OfficialPouya/Safety_Suite_For_Electric_Longboard/HalfWay_Report_Pouya/Diagrams:Photos/remote_pic1.jpg

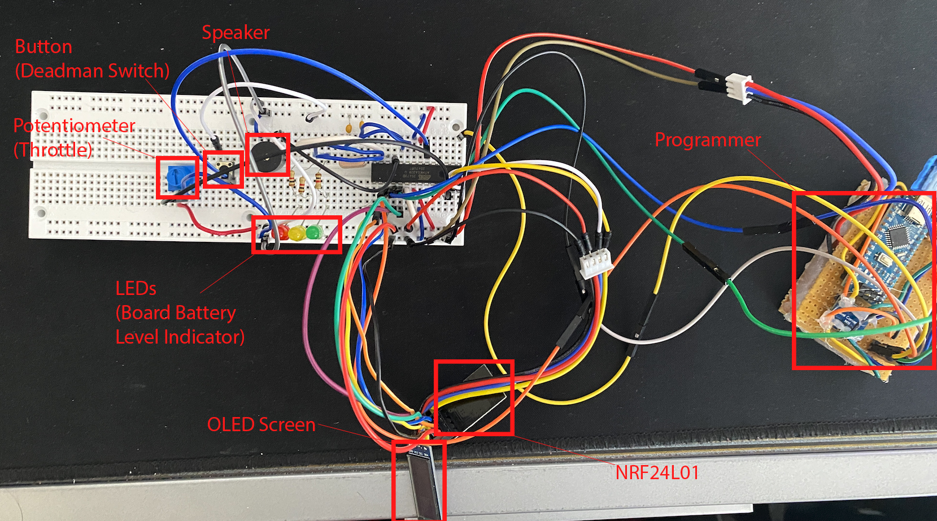
HalfWay_Report_Pouya/Diagrams:Photos/remote_pic1.jpg
