OfficialPouya/Safety_Suite_For_Electric_Longboard/3D_models/credit/Electric_longboard_remote_Heltec/images/7eb339b5feadf0e1b4344ece270d1d88_preview_featured.jpg

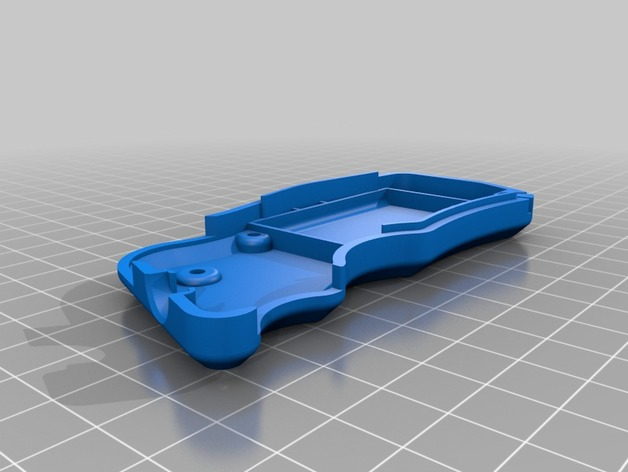
3D_models/credit/Electric_longboard_remote_Heltec/images/7eb339b5feadf0e1b4344ece270d1d88_preview_featured.jpg
