OfficialPouya/Safety_Suite_For_Electric_Longboard/README.md

# Safety Suite For Electric Longboard
This is my Senior Design (ECE 445) Project

The goal of the project is to increase Safety for electric longboard users. To find out more about the project, feel free to watch the presentation, demos, and the rest of this repository. This project would not have been possible without the help of Alex and Patrick. 

Best Overall Project Winner (Spring 2021)
-----
Best project out of 72 teams/projects

$1500 Award

Contributors
-----
[Pouya Akbarzadeh](https://github.com/OfficialPouya)

[Alexander Krysl](https://github.com/axkrysl47)

[Patrick Stach](https://github.com/pat-stach) 

Demo
-----
[Demo Videos](https://www.youtube.com/playlist?list=PLA1k06jt2lX-8_wawuwcJB9zIEW_f2nJa)

Presentation
-----
[Brief Presentaion](https://www.youtube.com/watch?v=MWs525hmZTg)

Final Results
-----
Board&Remote

OurTeam
