OfficialPouya/Safety_Suite_For_Electric_Longboard/3D_models/credit/Electric_longboard_remote_Heltec/images/69ffc595bfeba797f40aa1622941c01d_preview_featured.jpg

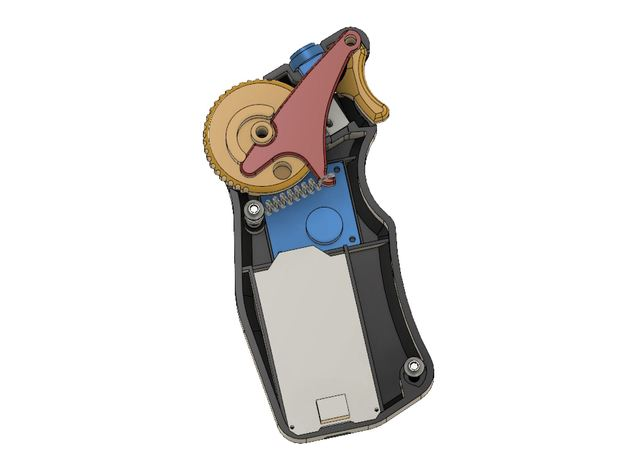
3D_models/credit/Electric_longboard_remote_Heltec/images/69ffc595bfeba797f40aa1622941c01d_preview_featured.jpg
