OfficialPouya/Safety_Suite_For_Electric_Longboard/3D_models/credit/Electric_longboard_remote_Heltec/images/98cde720821371f5c4195cfbfbd5da35_preview_featured.jpg

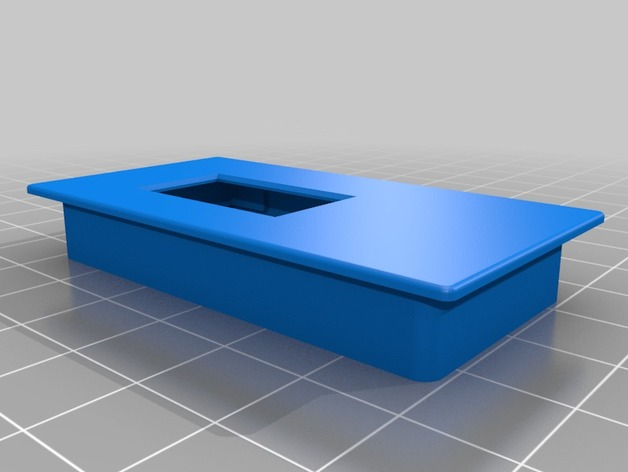
3D_models/credit/Electric_longboard_remote_Heltec/images/98cde720821371f5c4195cfbfbd5da35_preview_featured.jpg
