OfficialPouya/Safety_Suite_For_Electric_Longboard/3D_models/credit/Electric_longboard_remote_Heltec/images/386260dc76842ec5c13804833cbced2b_preview_featured.jpg

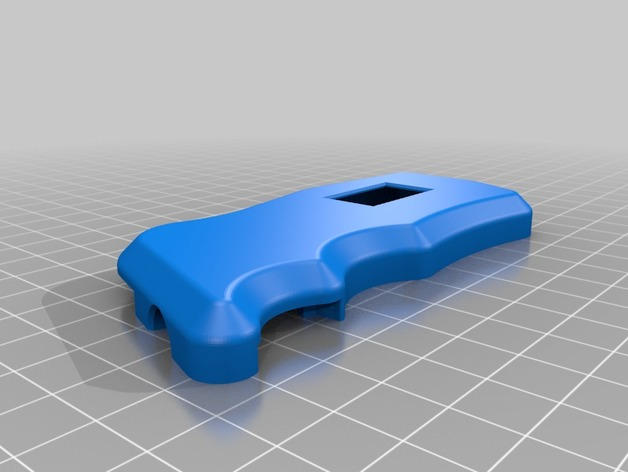
3D_models/credit/Electric_longboard_remote_Heltec/images/386260dc76842ec5c13804833cbced2b_preview_featured.jpg
