OfficialPouya/Safety_Suite_For_Electric_Longboard/3D_models/credit/Electric_longboard_remote_Heltec/images/a3805b81f7a539d40a509555a6355bbc_preview_featured.jpg

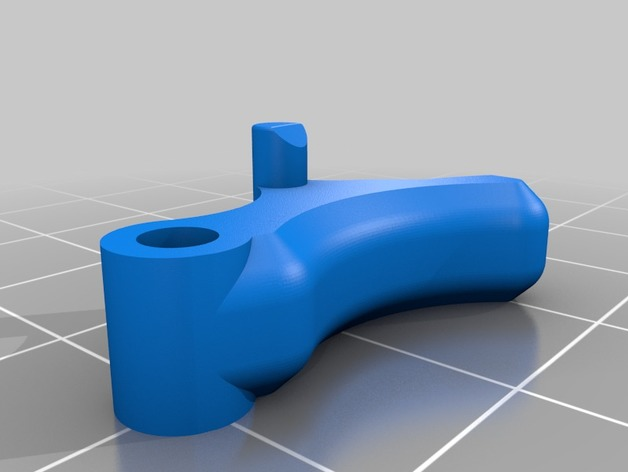
3D_models/credit/Electric_longboard_remote_Heltec/images/a3805b81f7a539d40a509555a6355bbc_preview_featured.jpg
