OfficialPouya/Safety_Suite_For_Electric_Longboard/3D_models/credit/Electric_longboard_remote_Heltec/images/b4461c6639c2007ad3c57c3150edbff9_preview_featured.jpg

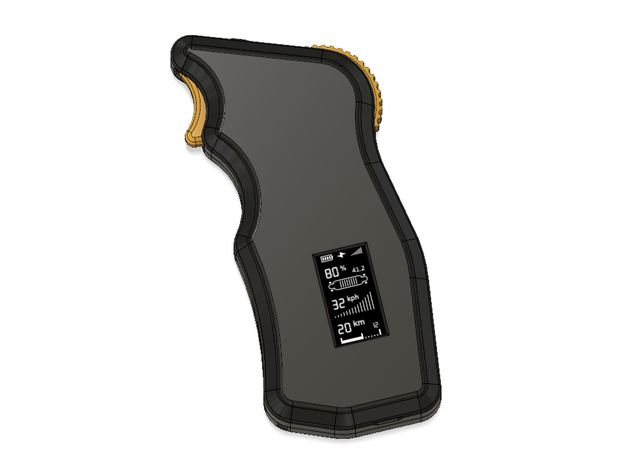
3D_models/credit/Electric_longboard_remote_Heltec/images/b4461c6639c2007ad3c57c3150edbff9_preview_featured.jpg
