OfficialPouya/Safety_Suite_For_Electric_Longboard/3D_models/credit/Electric_longboard_remote_Heltec/images/c8626185c7c38b2d3d5e2b3c0fde5403_preview_featured.jpg

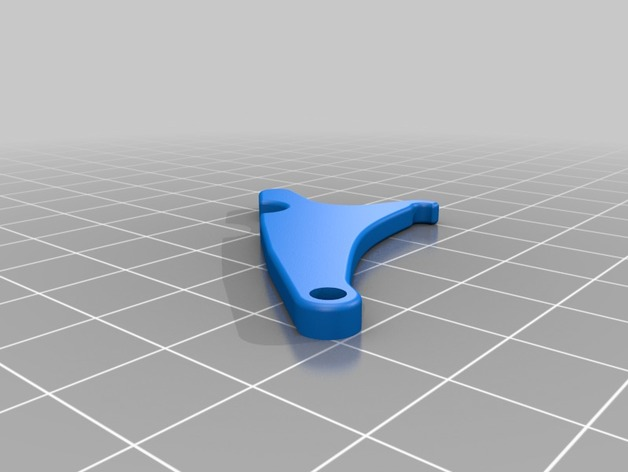
3D_models/credit/Electric_longboard_remote_Heltec/images/c8626185c7c38b2d3d5e2b3c0fde5403_preview_featured.jpg
