OfficialPouya/Safety_Suite_For_Electric_Longboard/3D_models/credit/Electric_longboard_remote_Heltec/images/d338848037ee6d17b909117afdbd7d65_preview_featured.jpg

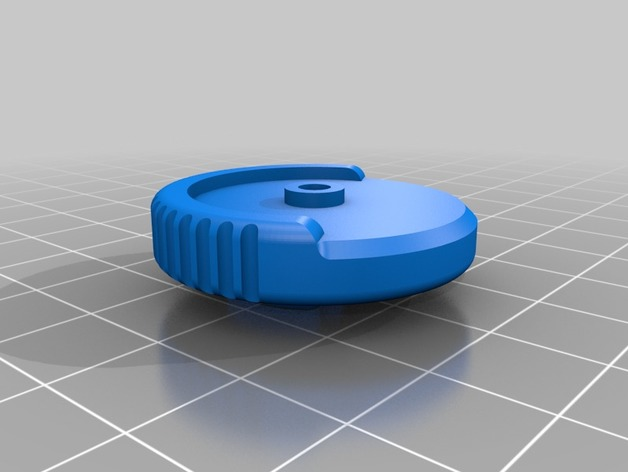
3D_models/credit/Electric_longboard_remote_Heltec/images/d338848037ee6d17b909117afdbd7d65_preview_featured.jpg
