OfficialPouya/Safety_Suite_For_Electric_Longboard/3D_models/credit/Electric_skateboard_motor_mount_-_Caliber_trucks/images/00dabf7ee72d4b01d702d320ba3350b1_preview_featured.jpg

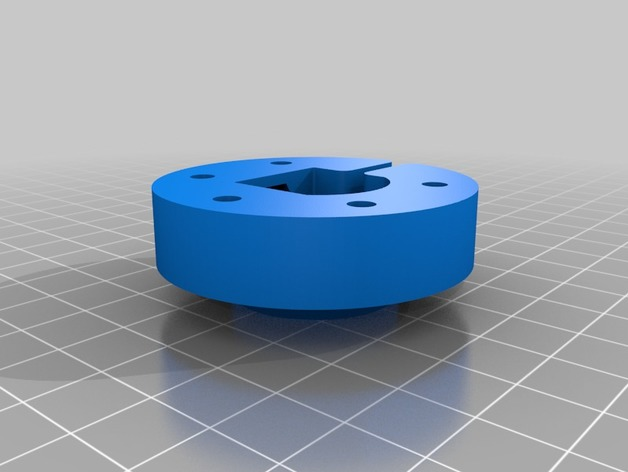
3D_models/credit/Electric_skateboard_motor_mount_-_Caliber_trucks/images/00dabf7ee72d4b01d702d320ba3350b1_preview_featured.jpg
