OfficialPouya/Safety_Suite_For_Electric_Longboard/3D_models/credit/Electric_skateboard_motor_mount_-_Caliber_trucks/images/650e578287d03ef3ec6c3ad758da1a24_preview_featured.jpg

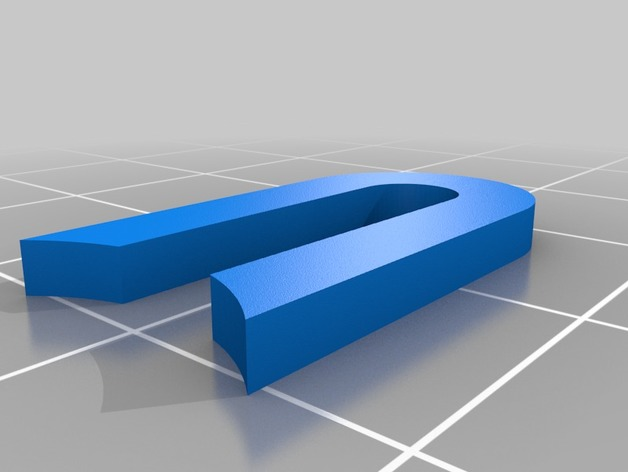
3D_models/credit/Electric_skateboard_motor_mount_-_Caliber_trucks/images/650e578287d03ef3ec6c3ad758da1a24_preview_featured.jpg
