OfficialPouya/Safety_Suite_For_Electric_Longboard/3D_models/credit/Electric_skateboard_motor_mount_-_Caliber_trucks/images/5272ebec7dc5c7aaa61b17ca818b53dd_preview_featured.jpg

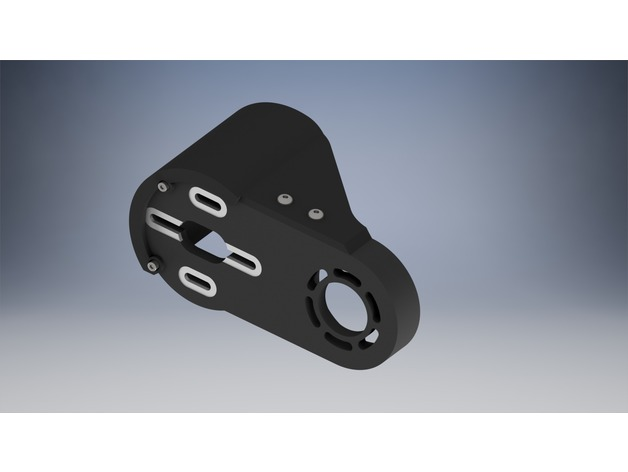
3D_models/credit/Electric_skateboard_motor_mount_-_Caliber_trucks/images/5272ebec7dc5c7aaa61b17ca818b53dd_preview_featured.jpg
