OfficialPouya/Safety_Suite_For_Electric_Longboard/3D_models/credit/Electric_skateboard_motor_mount_-_Caliber_trucks/images/8984e34767c9608245a1ef0f045a4798_preview_featured.jpg

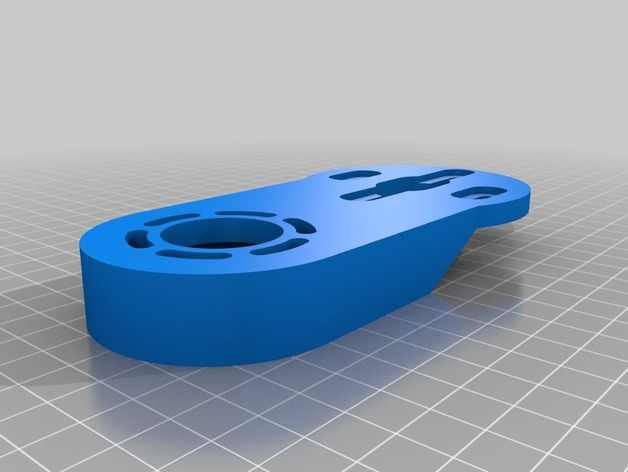
3D_models/credit/Electric_skateboard_motor_mount_-_Caliber_trucks/images/8984e34767c9608245a1ef0f045a4798_preview_featured.jpg
