OfficialPouya/Safety_Suite_For_Electric_Longboard/3D_models/credit/Electric_skateboard_motor_mount_-_Caliber_trucks/images/a8a3e114f2ad8216c0342388b4845f85_preview_featured.jpg

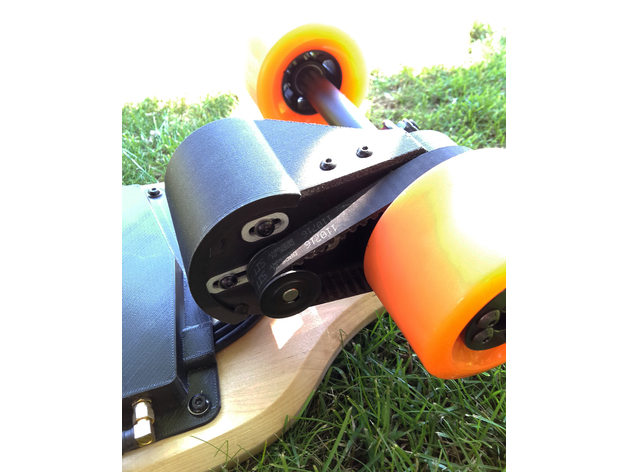
3D_models/credit/Electric_skateboard_motor_mount_-_Caliber_trucks/images/a8a3e114f2ad8216c0342388b4845f85_preview_featured.jpg
