OfficialPouya/Safety_Suite_For_Electric_Longboard/3D_models/credit/Electric_skateboard_motor_mount_-_Caliber_trucks/images/b66bf216e8f3e216b8c03a8b85245b85_preview_featured.jpg

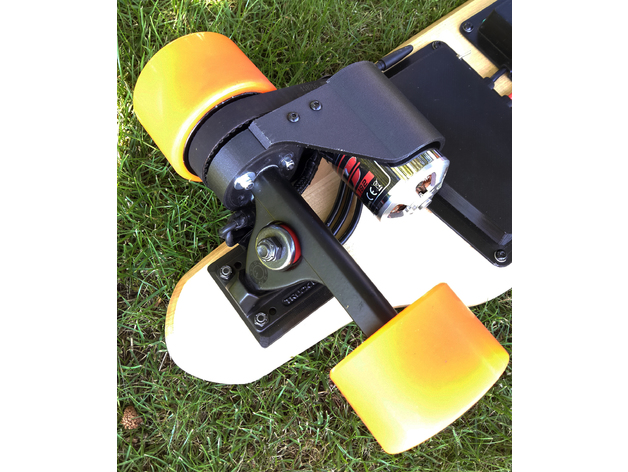
3D_models/credit/Electric_skateboard_motor_mount_-_Caliber_trucks/images/b66bf216e8f3e216b8c03a8b85245b85_preview_featured.jpg
