OfficialPouya/Safety_Suite_For_Electric_Longboard/3D_models/credit/Electric_skateboard_motor_mount_-_Caliber_trucks/images/bdc9b62eee6b2cbab2dfb2d8f4889339_preview_featured.jpg

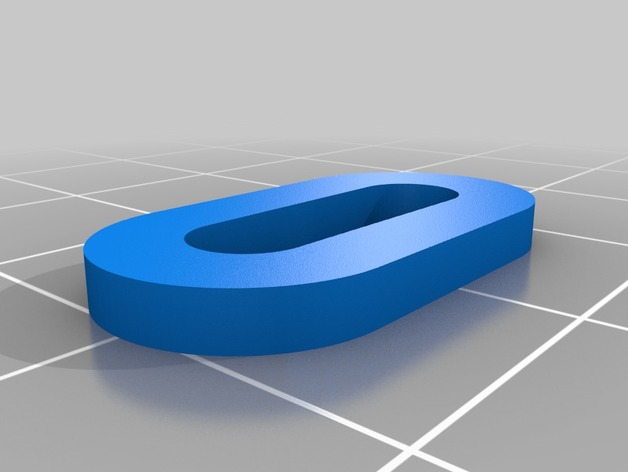
3D_models/credit/Electric_skateboard_motor_mount_-_Caliber_trucks/images/bdc9b62eee6b2cbab2dfb2d8f4889339_preview_featured.jpg
