OfficialPouya/Safety_Suite_For_Electric_Longboard/3D_models/credit/Electric_skateboard_motor_mount_-_Caliber_trucks/images/d86377b5828b7fca248c5126ea198edb_preview_featured.jpg

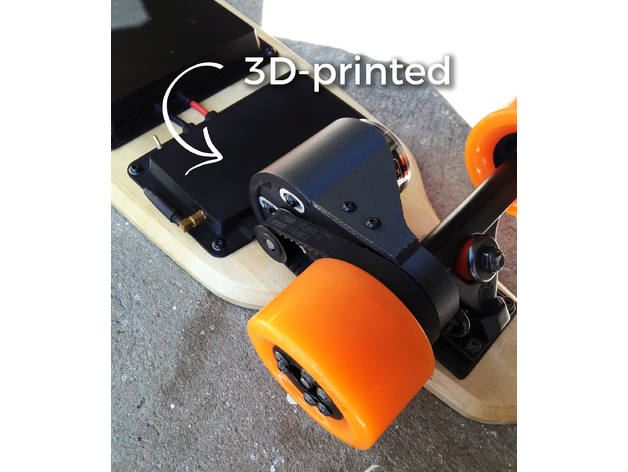
3D_models/credit/Electric_skateboard_motor_mount_-_Caliber_trucks/images/d86377b5828b7fca248c5126ea198edb_preview_featured.jpg
