OfficialPouya/Safety_Suite_For_Electric_Longboard/3D_models/credit/Electric_skateboard_motor_mount_-_Caliber_trucks/images/e82d7afcd378c9d0f728d8b83e60f790_preview_featured.jpg

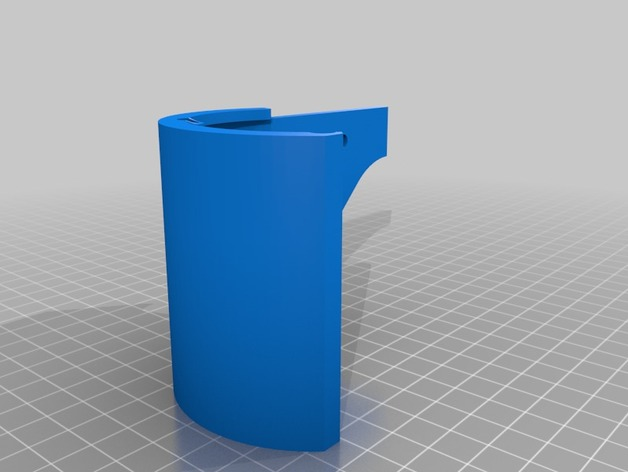
3D_models/credit/Electric_skateboard_motor_mount_-_Caliber_trucks/images/e82d7afcd378c9d0f728d8b83e60f790_preview_featured.jpg
