OfficialPouya/Safety_Suite_For_Electric_Longboard/3D_models/credit/Electric_skateboard_motor_mount_-_Caliber_trucks/images/f0a3eba2208476f3583bf658f56a1e3c_preview_featured.jpg

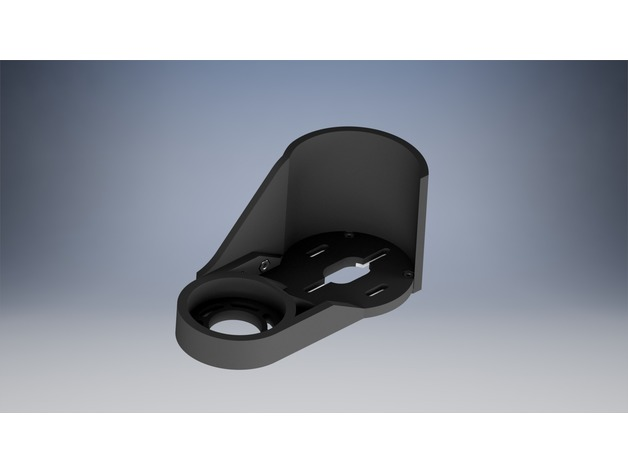
3D_models/credit/Electric_skateboard_motor_mount_-_Caliber_trucks/images/f0a3eba2208476f3583bf658f56a1e3c_preview_featured.jpg
