OfficialPouya/Safety_Suite_For_Electric_Longboard/3D_models/credit/Simple_Electric_longboard_remote_-_Arduino_controlled/images/1ada9a45c209b7b583cf4957225b233d_preview_featured.jpg

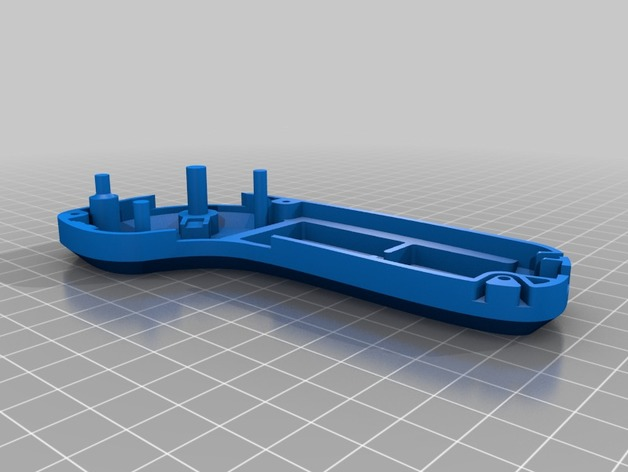
3D_models/credit/Simple_Electric_longboard_remote_-_Arduino_controlled/images/1ada9a45c209b7b583cf4957225b233d_preview_featured.jpg
