OfficialPouya/Safety_Suite_For_Electric_Longboard/3D_models/credit/Simple_Electric_longboard_remote_-_Arduino_controlled/images/3b2ae663a349fbd48012c7a0f8ea2945_preview_featured.jpg

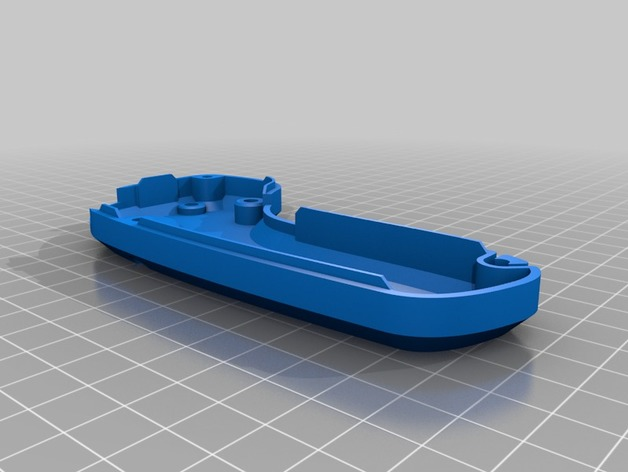
3D_models/credit/Simple_Electric_longboard_remote_-_Arduino_controlled/images/3b2ae663a349fbd48012c7a0f8ea2945_preview_featured.jpg
