OfficialPouya/Safety_Suite_For_Electric_Longboard/3D_models/credit/Simple_Electric_longboard_remote_-_Arduino_controlled/images/6b917f084faacf58960fc0e06d5b0af2_preview_featured.jpg

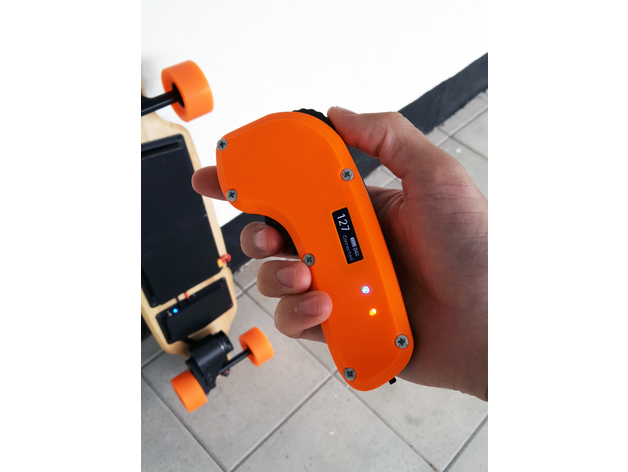
3D_models/credit/Simple_Electric_longboard_remote_-_Arduino_controlled/images/6b917f084faacf58960fc0e06d5b0af2_preview_featured.jpg
