OfficialPouya/Safety_Suite_For_Electric_Longboard/3D_models/credit/Simple_Electric_longboard_remote_-_Arduino_controlled/images/11ebd2f3d5eb1cffd68fecb412f7cab5_preview_featured.jpg

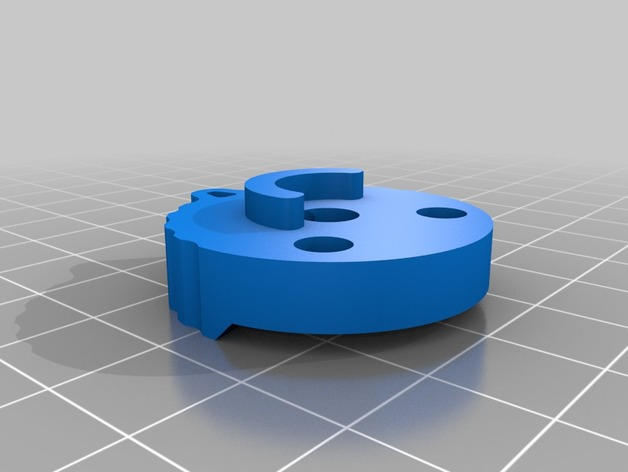
3D_models/credit/Simple_Electric_longboard_remote_-_Arduino_controlled/images/11ebd2f3d5eb1cffd68fecb412f7cab5_preview_featured.jpg
