OfficialPouya/Safety_Suite_For_Electric_Longboard/3D_models/credit/Simple_Electric_longboard_remote_-_Arduino_controlled/images/17f00339c16d989a47a086a7920d7a7d_preview_featured.jpg

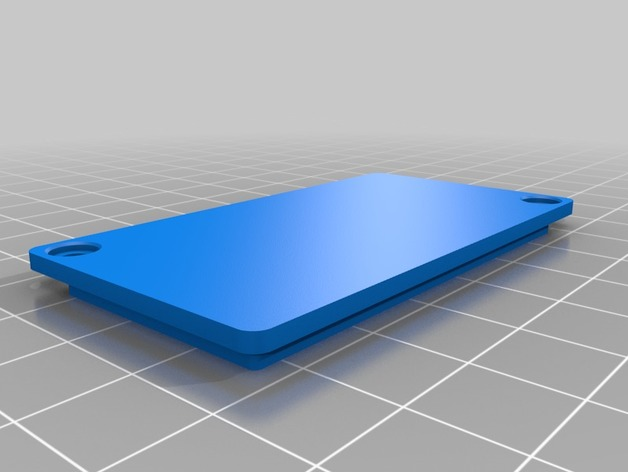
3D_models/credit/Simple_Electric_longboard_remote_-_Arduino_controlled/images/17f00339c16d989a47a086a7920d7a7d_preview_featured.jpg
