OfficialPouya/Safety_Suite_For_Electric_Longboard/3D_models/credit/Simple_Electric_longboard_remote_-_Arduino_controlled/images/018fba42ba686e32060c9fe2c2261120_preview_featured.jpg

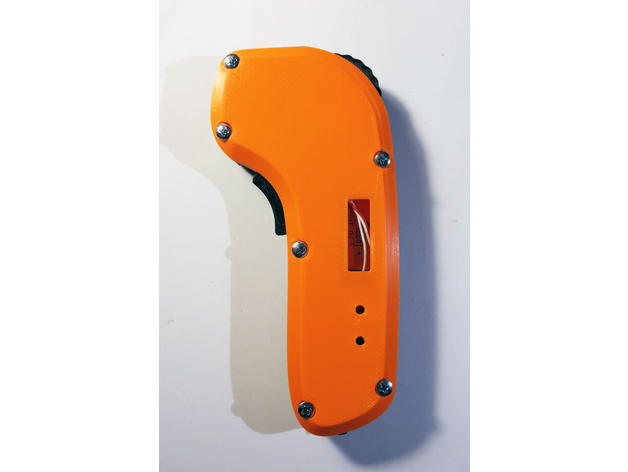
3D_models/credit/Simple_Electric_longboard_remote_-_Arduino_controlled/images/018fba42ba686e32060c9fe2c2261120_preview_featured.jpg
