OfficialPouya/Safety_Suite_For_Electric_Longboard/3D_models/credit/Simple_Electric_longboard_remote_-_Arduino_controlled/images/141a299b2f25cc87eeaa98db502500f5_preview_featured.jpg

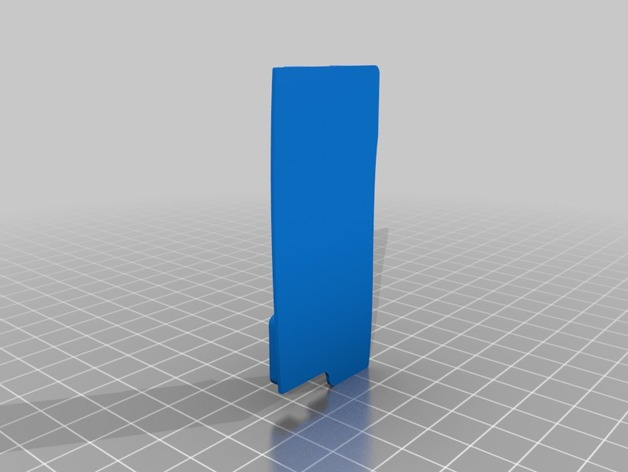
3D_models/credit/Simple_Electric_longboard_remote_-_Arduino_controlled/images/141a299b2f25cc87eeaa98db502500f5_preview_featured.jpg
