OfficialPouya/Safety_Suite_For_Electric_Longboard/3D_models/credit/Simple_Electric_longboard_remote_-_Arduino_controlled/images/55659f481606f12118e7dbcee9aad6fd_preview_featured.jpg

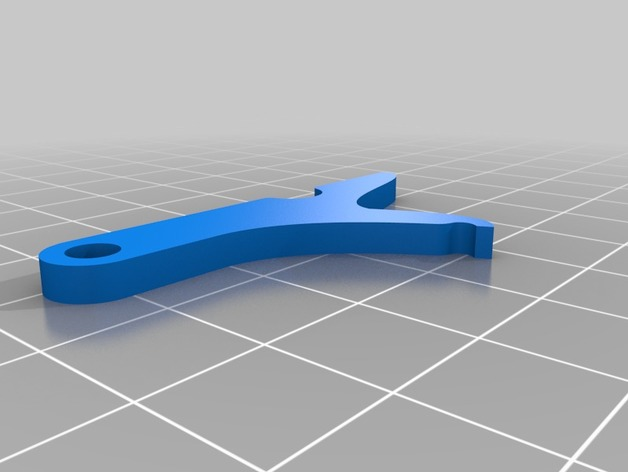
3D_models/credit/Simple_Electric_longboard_remote_-_Arduino_controlled/images/55659f481606f12118e7dbcee9aad6fd_preview_featured.jpg
