OfficialPouya/Safety_Suite_For_Electric_Longboard/3D_models/credit/Simple_Electric_longboard_remote_-_Arduino_controlled/images/a1e6dd522270614e2ebc6771adb747c4_preview_featured.jpg

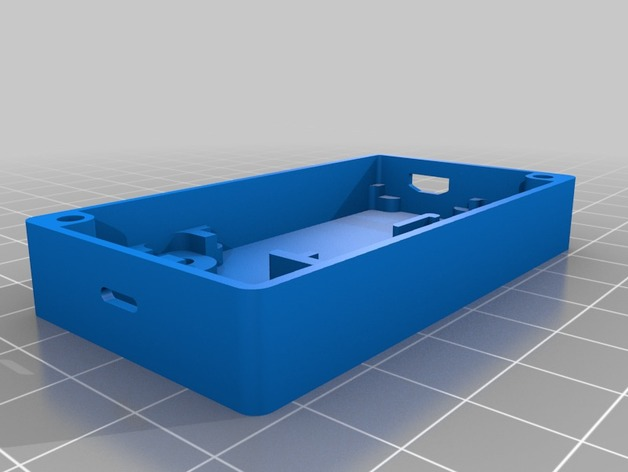
3D_models/credit/Simple_Electric_longboard_remote_-_Arduino_controlled/images/a1e6dd522270614e2ebc6771adb747c4_preview_featured.jpg
