OfficialPouya/Safety_Suite_For_Electric_Longboard/3D_models/credit/Simple_Electric_longboard_remote_-_Arduino_controlled/images/ba5dbd823eb74a298b38a080a1d7cd9e_preview_featured.jpg

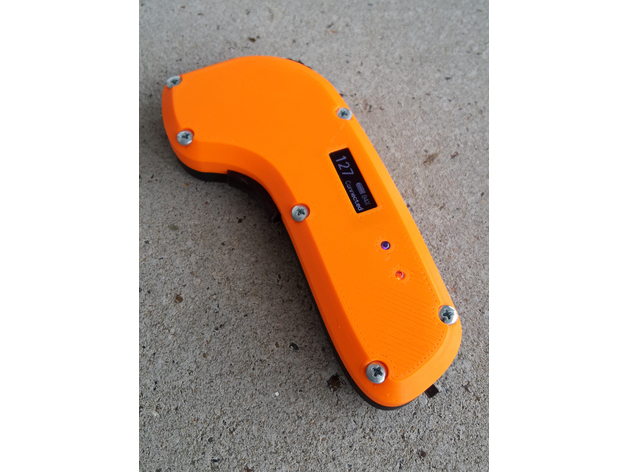
3D_models/credit/Simple_Electric_longboard_remote_-_Arduino_controlled/images/ba5dbd823eb74a298b38a080a1d7cd9e_preview_featured.jpg
