OfficialPouya/Safety_Suite_For_Electric_Longboard/3D_models/credit/Simple_Electric_longboard_remote_-_Arduino_controlled/images/c1f2ee958971d7c7970c5f8eeb328b37_preview_featured.jpg

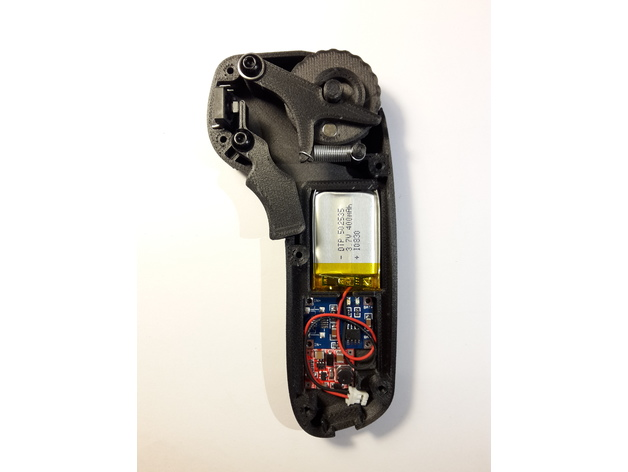
3D_models/credit/Simple_Electric_longboard_remote_-_Arduino_controlled/images/c1f2ee958971d7c7970c5f8eeb328b37_preview_featured.jpg
