OfficialPouya/Safety_Suite_For_Electric_Longboard/3D_models/credit/Simple_Electric_longboard_remote_-_Arduino_controlled/images/e4e441251442551cd49a33c49696ac5a_preview_featured.jpg

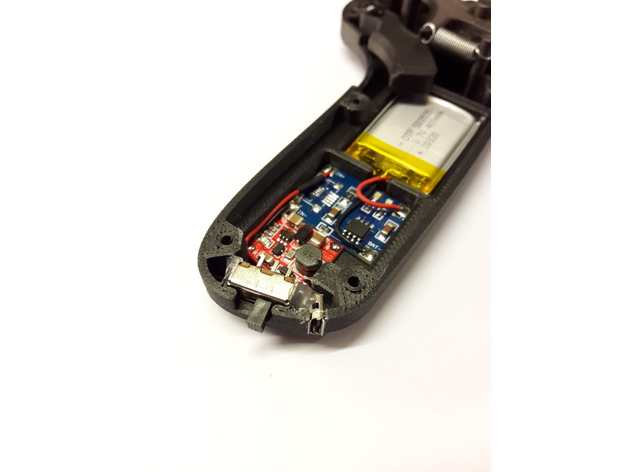
3D_models/credit/Simple_Electric_longboard_remote_-_Arduino_controlled/images/e4e441251442551cd49a33c49696ac5a_preview_featured.jpg
