OfficialPouya/Safety_Suite_For_Electric_Longboard/3D_models/credit/Simple_Electric_longboard_remote_-_Arduino_controlled/images/f8306a2e75ba35f288b965988df9bf7a_preview_featured.jpg

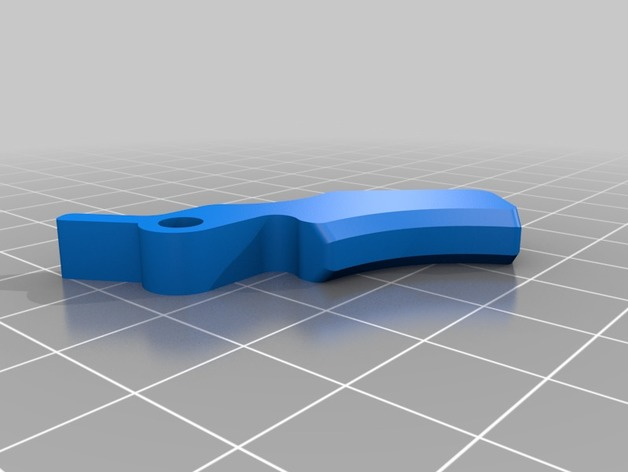
3D_models/credit/Simple_Electric_longboard_remote_-_Arduino_controlled/images/f8306a2e75ba35f288b965988df9bf7a_preview_featured.jpg
