OfficialPouya/Safety_Suite_For_Electric_Longboard/eagle/PCB Orders/3_18_21_Remote_DIP/pcbremote_BOM.txt

Partlist exported from C:/Users/Patrick/Documents/GitHub/senior_design/eagle/PCB Orders/3_18_21_Remote_DIP/pcbremote.sch at 4/3/2021 3:05 PM

Part          Value         Device                Package                Description                                                                                                     BUILT_BY    DESCRIPTION                                                                                                                DIGI-KEY_PART_NUMBER MANUFACTURER_PART_NUMBER MF                MP           MPN           OC_FARNELL OC_NEWARK PACKAGE                     POPULARITY PROD_ID    PURCHASE-URL                                                  SOURCELIBRARY         SPICEPREFIX SUPPLIER VALUE         VENDOR           
3.3V                        PINHD-1X1             1X01                   PIN HEADER                                                                                                                                                                                                                                                                                                                                                                                         64                                                                                                                                                            
A0                          PINHD-1X1             1X01                   PIN HEADER                                                                                                                                                                                                                                                                                                                                                                                         64                                                                                                                                                            
A1                          PINHD-1X1             1X01                   PIN HEADER                                                                                                                                                                                                                                                                                                                                                                                         64                                                                                                                                                            
A2                          PINHD-1X1             1X01                   PIN HEADER                                                                                                                                                                                                                                                                                                                                                                                         64                                                                                                                                                            
A3                          PINHD-1X1             1X01                   PIN HEADER                                                                                                                                                                                                                                                                                                                                                                                         64                                                                                                                                                            
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
SCL                         PINHD-1X1             1X01                   PIN HEADER                                                                                                                                                                                                                                                                                                                                                                                         64                                                                                                                                                            
SDA                         PINHD-1X1             1X01                   PIN HEADER                                                                                                                                                                                                                                                                                                                                                                                         64                                                                                                                                                            
STATUS                      PINHD-1X1             1X01                   PIN HEADER                                                                                                                                                                                                                                                                                                                                                                                         64                                                                                                                                                            
U1            TPS73233DCQR  TPS73233DCQR          SOT127P706X180-6N                                                                                                                                   250-mA, high-accuracy, ultra-low-dropout voltage regulator with reverse current protection & enable 6-SOT-223 -40 to 125  296-16866-1-ND                                Texas Instruments TPS73233DCQR                                    SOT-223-6 Texas Instruments                       https://pricing.snapeda.com/search/part/TPS73233DCQR/?ref=eda                                                                           
U2            ATMEGA328P-PU ATMEGA328P-PU         DIP254P762X457-28      8-bit Microcontroller with In-System Programmable Flash                                                                                                                                                                                                                                                                             ATMEGA328P-PU 1715487    15R0268   PDIP-28                                                                                                                                           Atmel                                   
U3            LTC1540CS8PBF LTC1540CS8PBF         SO-8_S_LIT                                                                                                                             EMA_UL_Team                                                                                                                                                 ltc1540cs8#pbf                                                                                                                                                                                             LinearTech_2016_03_08                                    Linear Technology
U4            MCP73831/OT   MCP73831/OT           SOT23-5L               MCP73831/2                                                                                                                                                                                                                                                                                                                                                                                                                                                                                                                                                       
USB           MICRO-USBV2   MICRO-USBV2           MICRO-USB-2            Micro USB B connector                                                                                                                                                                                                                                                                                                                                                                                                                                                                                                                                            
VCC                         PINHD-1X1             1X01                   PIN HEADER                                                                                                                                                                                                                                                                                                                                                                                         64                                                                                                                                                            
VIN                         PINHD-1X1             1X01                   PIN HEADER                                                                                                                                                                                                                                                                                                                                                                                         64                                                                                                                                                            
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
Y2            8MHz          CRYSTAL-8MHZSMD-5X3.2 CRYSTAL-SMD-5X3.2-4PAD 8MHz Crystal                                                                                                                                                                                                                                                                                                                                                                                                  XTAL-09431                                                                                                          8MHz
