OfficialPouya/Safety_Suite_For_Electric_Longboard/3D_models/3_2_21/ring.stl

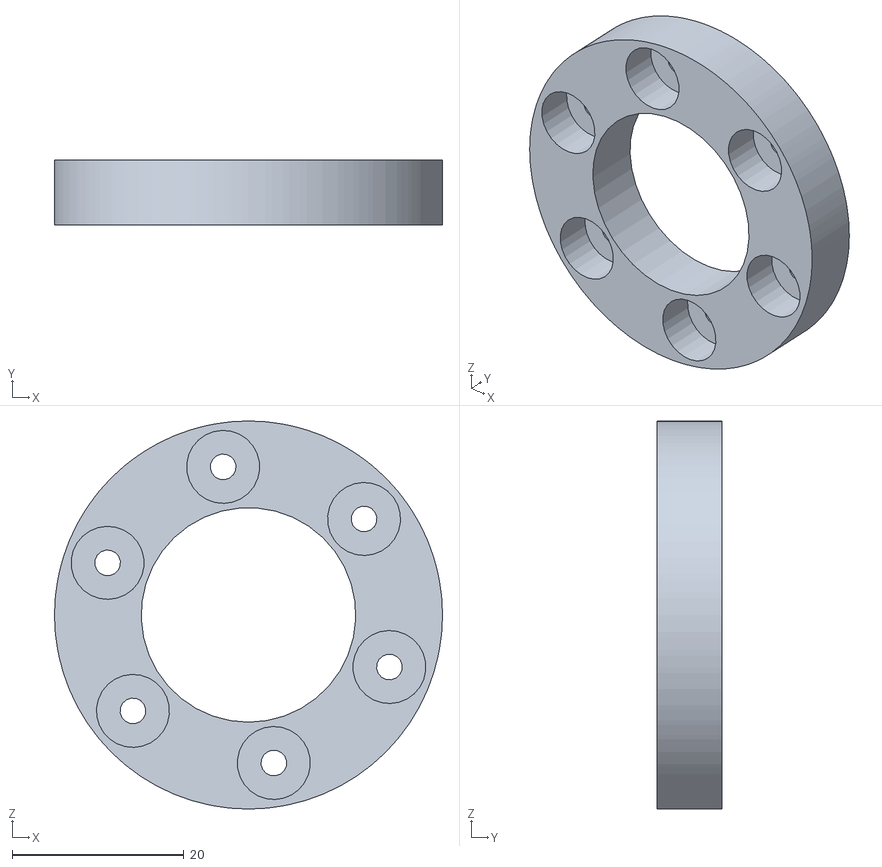
[picture p79: CAD file, 2021-04-29]
3D_models/3_2_21/ring.stl
45.2 x 7.62 x 45.2
