OfficialPouya/Safety_Suite_For_Electric_Longboard/3D_models/credit/Electric_longboard_remote_Heltec/files/Bottom.stl

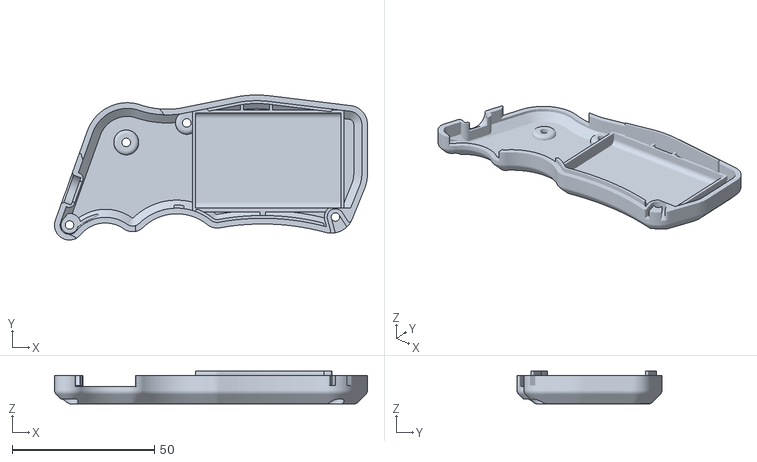
[picture p80: CAD file, 2021-04-29]
3D_models/credit/Electric_longboard_remote_Heltec/files/Bottom.stl
110.2 x 51.0 x 11.6
