OfficialPouya/Safety_Suite_For_Electric_Longboard/3D_models/credit/Electric_skateboard_motor_mount_-_Caliber_trucks/files/slotspacer.stl

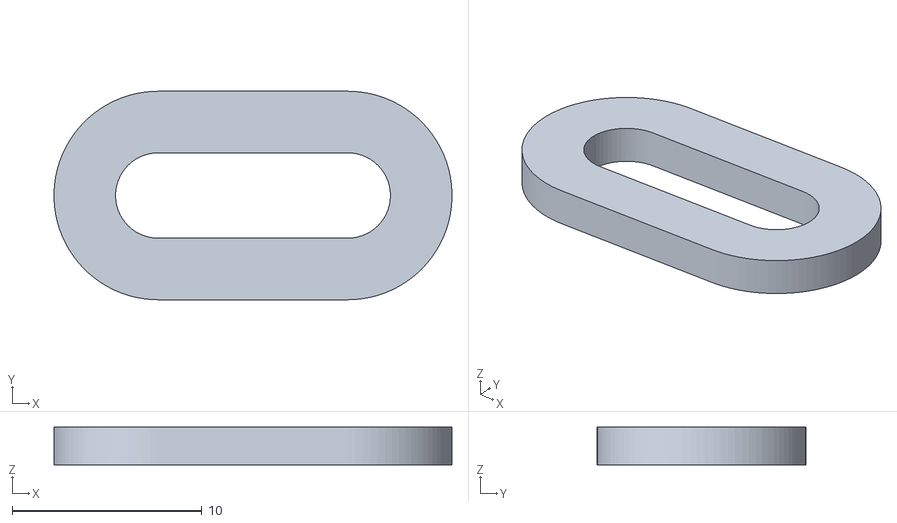
[picture p81: CAD file, 2021-04-29]
3D_models/credit/Electric_skateboard_motor_mount_-_Caliber_trucks/files/slotspacer.stl
21.0 x 11.0 x 2.00
