OfficialPouya/Safety_Suite_For_Electric_Longboard/3D_models/credit/Remote/plate.stp

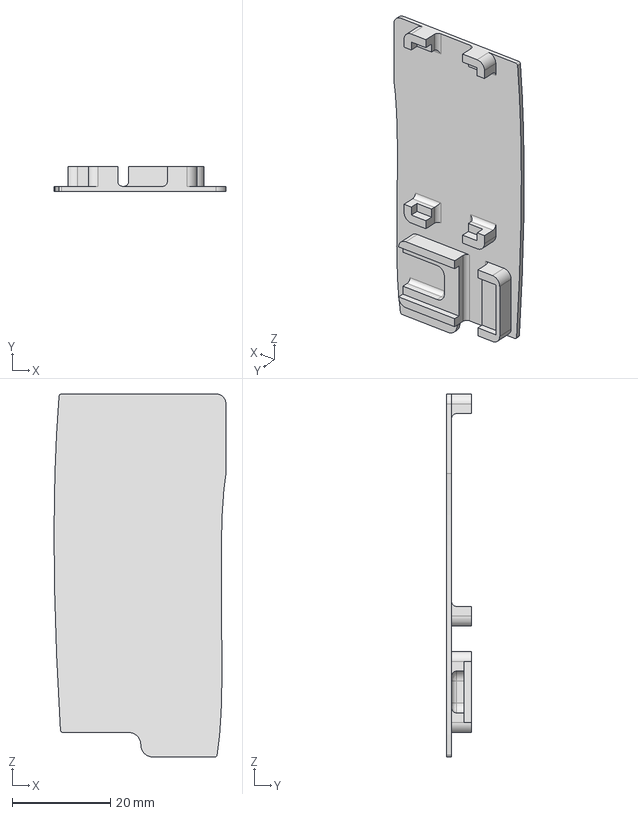
[picture p82: CAD file, 2021-04-29]
3D_models/credit/Remote/plate.stp
35.1 x 5.00 x 74.0 mm
