OfficialPouya/Safety_Suite_For_Electric_Longboard/3D_models/credit/Simple_Electric_longboard_remote_-_Arduino_controlled/files/trigger.stl

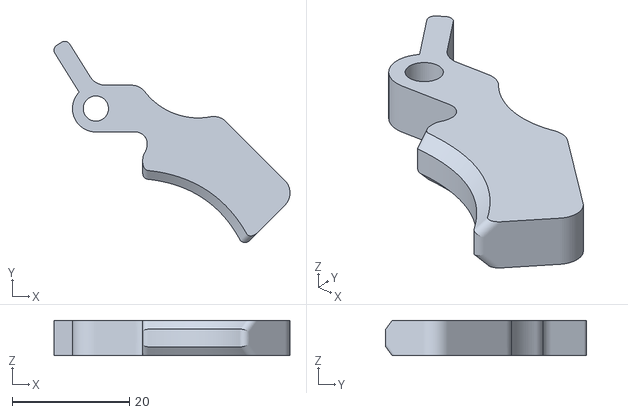
[picture p83: CAD file, 2021-04-29]
3D_models/credit/Simple_Electric_longboard_remote_-_Arduino_controlled/files/trigger.stl
40.3 x 34.4 x 6.00
