OfficialPouya/Safety_Suite_For_Electric_Longboard/3D_models/just_hall holder.stl

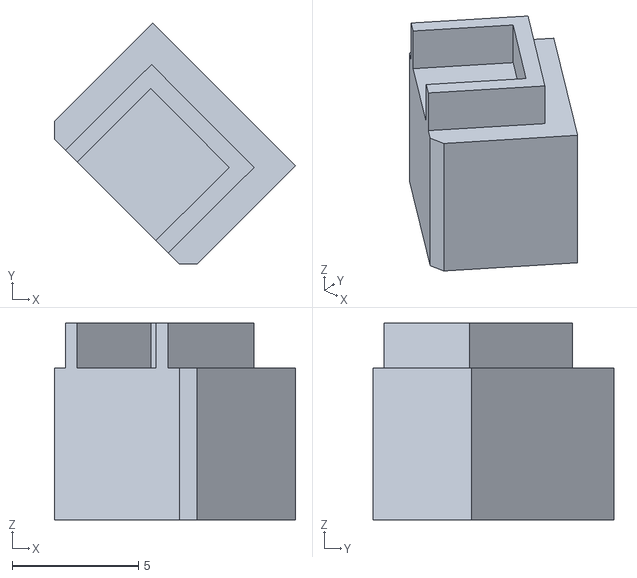
[picture p84: CAD file, 2021-04-29]
3D_models/just_hall holder.stl
9.56 x 9.56 x 7.80
