OfficialPouya/Safety_Suite_For_Electric_Longboard/3D_models/remote/stl/shell_mesh.stl

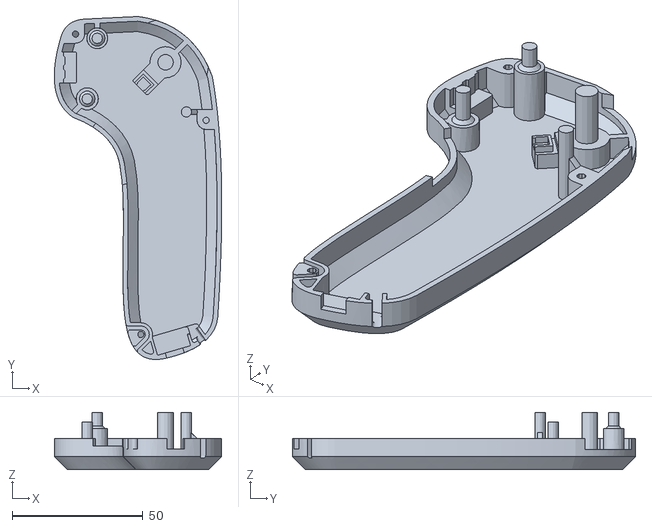
[picture p85: CAD file, 2021-04-29]
3D_models/remote/stl/shell_mesh.stl
64.1 x 131.3 x 22.0
