OfficialPouya/Safety_Suite_For_Electric_Longboard/eagle/PCB Orders/4_6_21_Remote_SMD/pcbremote.dxf

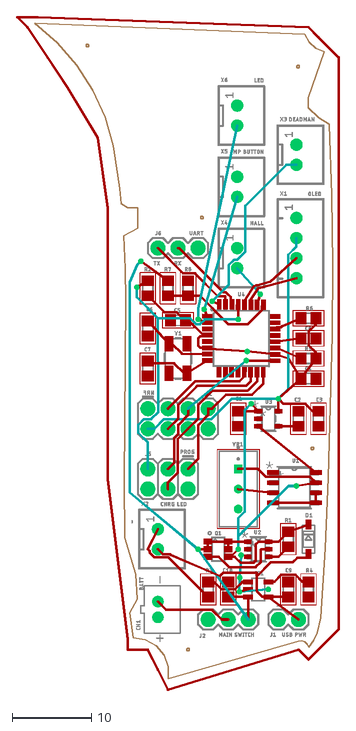
[picture p86: CAD file, 2021-04-29]
eagle/PCB Orders/4_6_21_Remote_SMD/pcbremote.dxf
40.9 x 85.3
