OfficialPouya/Safety_Suite_For_Electric_Longboard/3D_models/3_2_21/trucks.stl

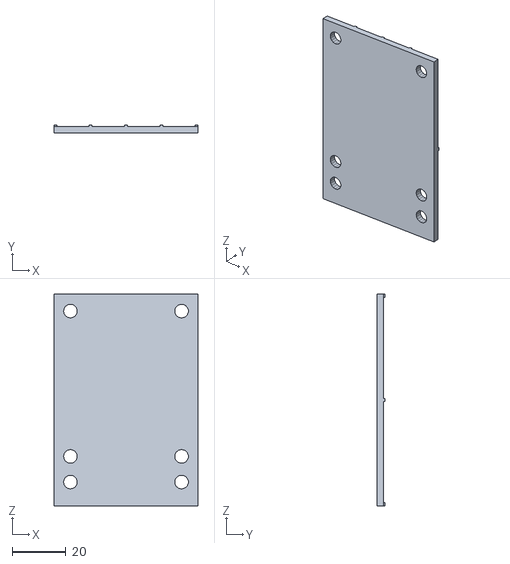
[picture p87: CAD file, 2021-04-29]
3D_models/3_2_21/trucks.stl
53.3 x 3.04 x 78.7
