OfficialPouya/Safety_Suite_For_Electric_Longboard/3D_models/credit/Electric_longboard_remote_Heltec/files/Springy.stl

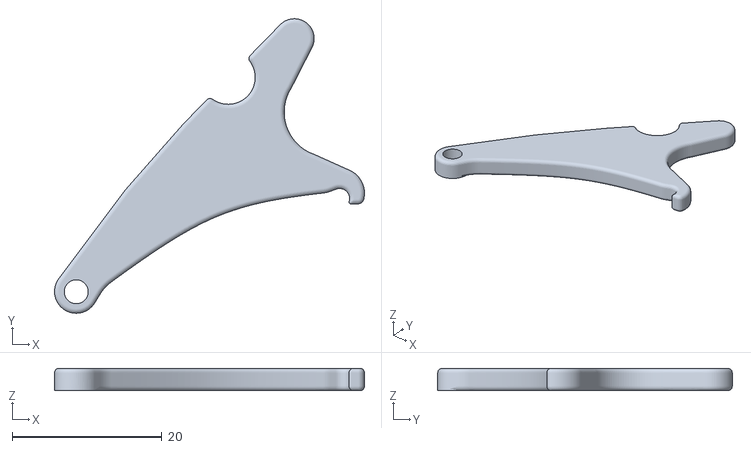
[picture p88: CAD file, 2021-04-29]
3D_models/credit/Electric_longboard_remote_Heltec/files/Springy.stl
41.5 x 39.4 x 3.00
