OfficialPouya/Safety_Suite_For_Electric_Longboard/3D_models/credit/Electric_skateboard_motor_mount_-_Caliber_trucks/files/mount-no-shield.stl

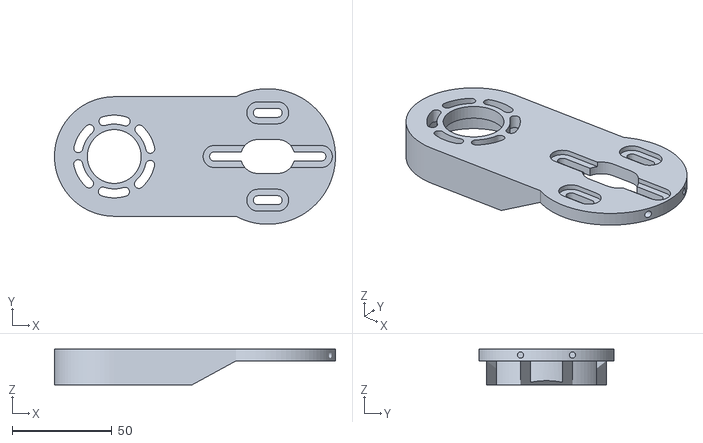
[picture p89: CAD file, 2021-04-29]
3D_models/credit/Electric_skateboard_motor_mount_-_Caliber_trucks/files/mount-no-shield.stl
141.0 x 68.0 x 18.0
