OfficialPouya/Safety_Suite_For_Electric_Longboard/3D_models/3_2_21/hall_toll.stl

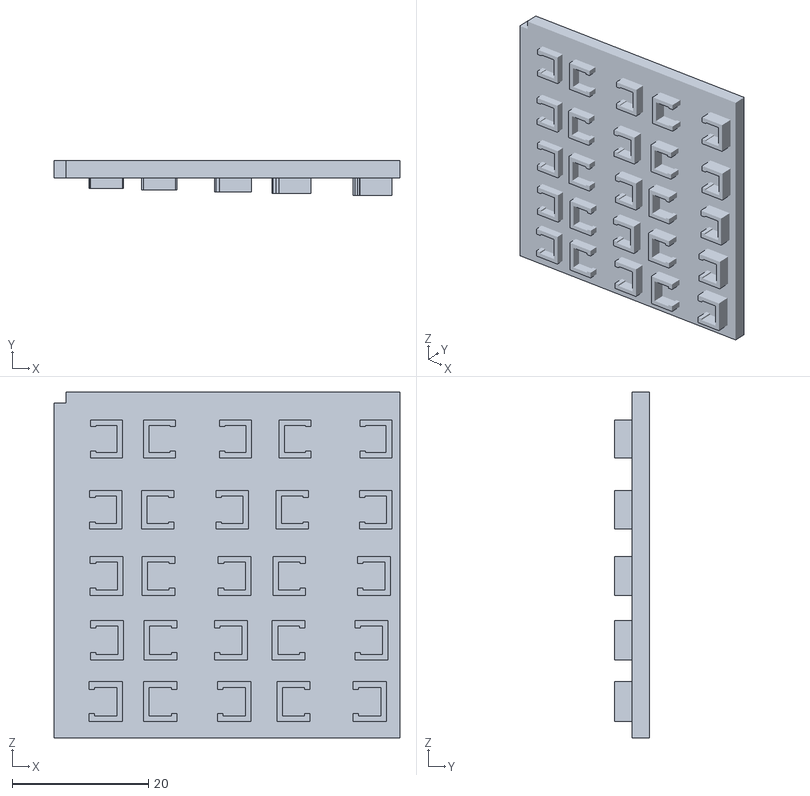
[picture p90: CAD file, 2021-04-29]
3D_models/3_2_21/hall_toll.stl
50.8 x 5.08 x 50.8
