OfficialPouya/Safety_Suite_For_Electric_Longboard/3D_models/credit/Electric_longboard_remote_Heltec/files/Top.stl

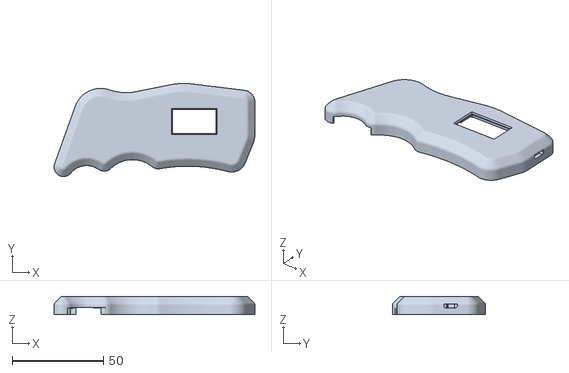
[picture p91: CAD file, 2021-04-29]
3D_models/credit/Electric_longboard_remote_Heltec/files/Top.stl
110.2 x 51.0 x 10.0
