OfficialPouya/Safety_Suite_For_Electric_Longboard/3D_models/credit/Electric_skateboard_motor_mount_-_Caliber_trucks/files/caliber.stl

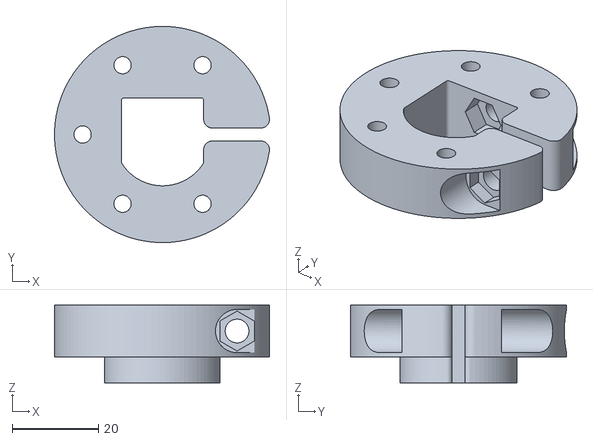
[picture p92: CAD file, 2021-04-29]
3D_models/credit/Electric_skateboard_motor_mount_-_Caliber_trucks/files/caliber.stl
49.7 x 50.0 x 18.0
