OfficialPouya/Safety_Suite_For_Electric_Longboard/3D_models/credit/Simple_Electric_longboard_remote_-_Arduino_controlled/files/throttle.stl

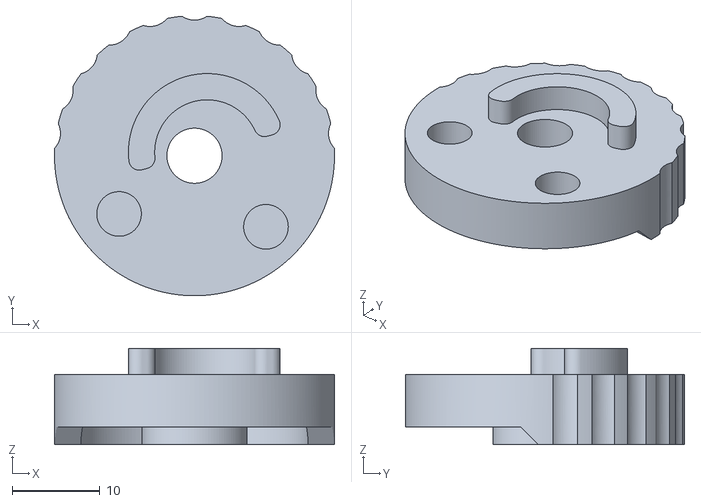
[picture p93: CAD file, 2021-04-29]
3D_models/credit/Simple_Electric_longboard_remote_-_Arduino_controlled/files/throttle.stl
32.0 x 31.9 x 11.0
