OfficialPouya/Safety_Suite_For_Electric_Longboard/3D_models/credit/Electric_longboard_remote_Heltec/files/Throttle.stl

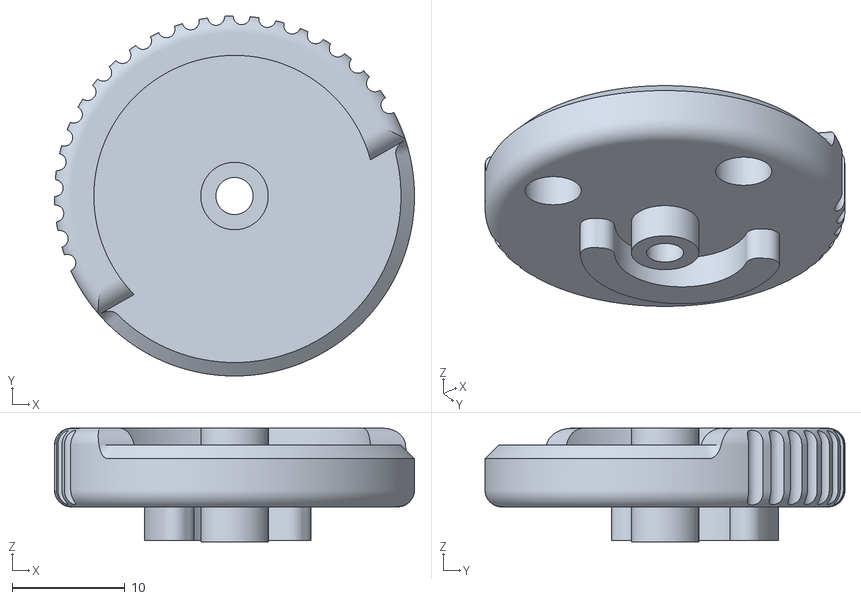
[picture p94: CAD file, 2021-04-29]
3D_models/credit/Electric_longboard_remote_Heltec/files/Throttle.stl
32.0 x 32.0 x 10.1
