OfficialPouya/Safety_Suite_For_Electric_Longboard/3D_models/credit/Electric_skateboard_motor_mount_-_Caliber_trucks/files/shield.stl

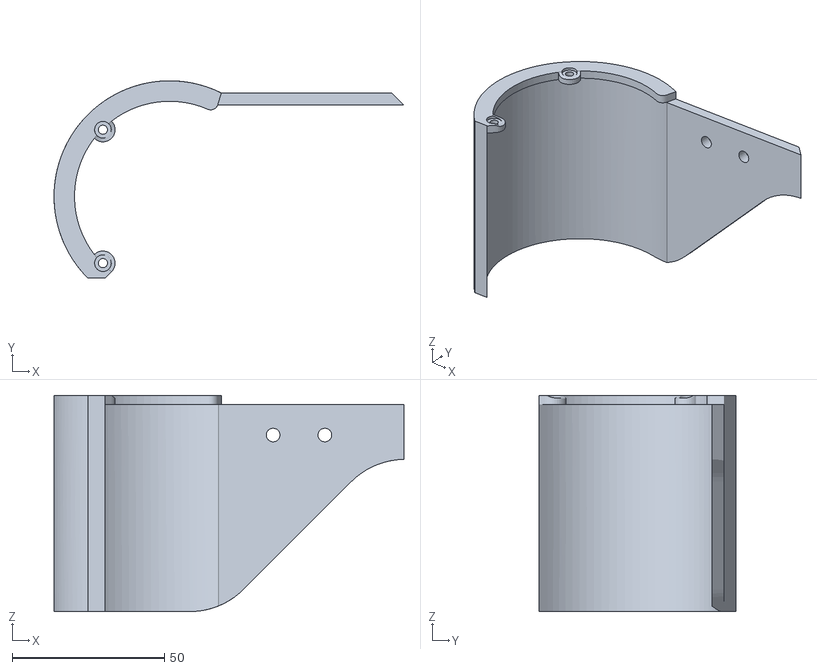
[picture p95: CAD file, 2021-04-29]
3D_models/credit/Electric_skateboard_motor_mount_-_Caliber_trucks/files/shield.stl
115.0 x 64.9 x 71.0
