OfficialPouya/Safety_Suite_For_Electric_Longboard/3D_models/credit/Simple_Electric_longboard_remote_-_Arduino_controlled/files/throttle-knob.stl

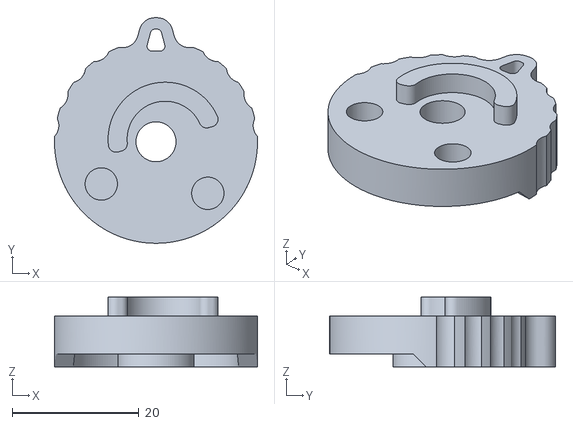
[picture p96: CAD file, 2021-04-29]
3D_models/credit/Simple_Electric_longboard_remote_-_Arduino_controlled/files/throttle-knob.stl
32.0 x 35.6 x 11.0
