OfficialPouya/Safety_Suite_For_Electric_Longboard/3D_models/credit/Electric_longboard_remote_Heltec/files/Receiver.stl

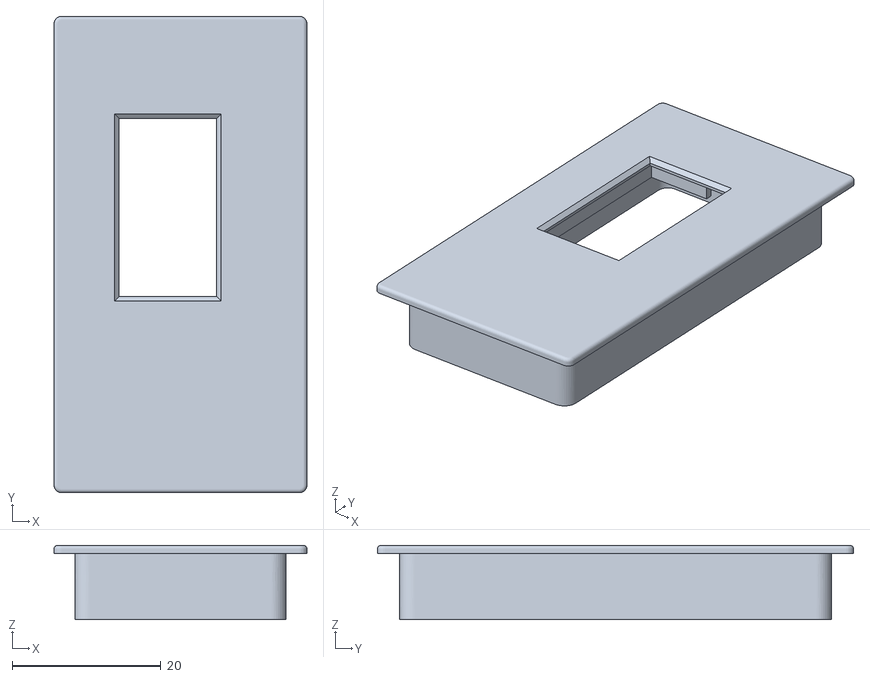
[picture p97: CAD file, 2021-04-29]
3D_models/credit/Electric_longboard_remote_Heltec/files/Receiver.stl
34.0 x 64.0 x 10.0
