OfficialPouya/Safety_Suite_For_Electric_Longboard/3D_models/credit/Electric_skateboard_motor_mount_-_Caliber_trucks/files/mount.stl

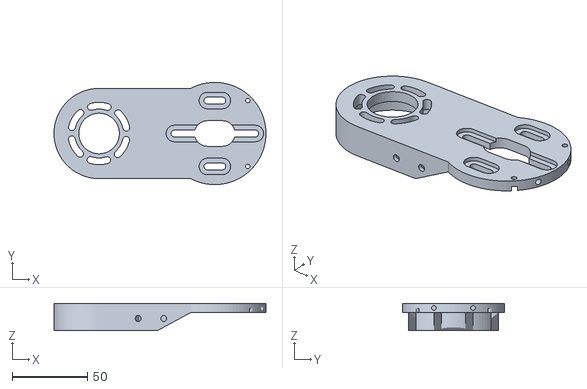
[picture p98: CAD file, 2021-04-29]
3D_models/credit/Electric_skateboard_motor_mount_-_Caliber_trucks/files/mount.stl
141.0 x 68.0 x 18.0
