OfficialPouya/Safety_Suite_For_Electric_Longboard/3D_models/credit/Simple_Electric_longboard_remote_-_Arduino_controlled/files/springy.stl

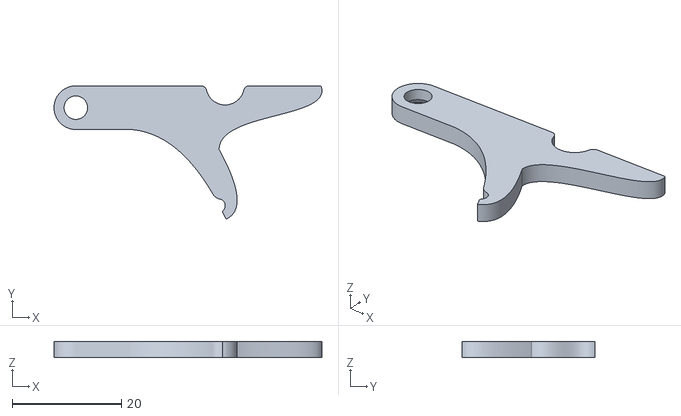
[picture p99: CAD file, 2021-04-29]
3D_models/credit/Simple_Electric_longboard_remote_-_Arduino_controlled/files/springy.stl
49.1 x 24.4 x 3.00
