OfficialPouya/Safety_Suite_For_Electric_Longboard/3D_models/credit/Electric_longboard_remote_Heltec/files/Trigger.stl

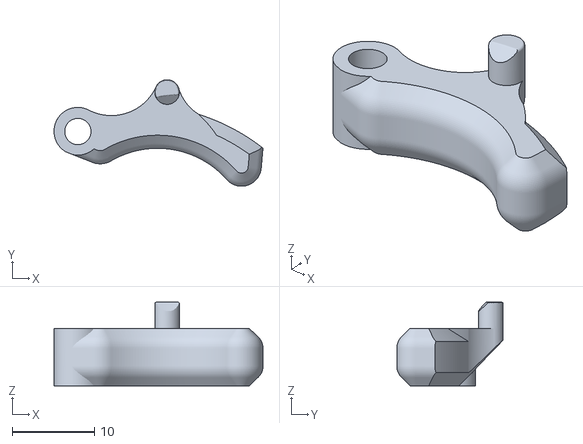
[picture p100: CAD file, 2021-04-29]
3D_models/credit/Electric_longboard_remote_Heltec/files/Trigger.stl
25.5 x 13.0 x 10.2
