OfficialPouya/Safety_Suite_For_Electric_Longboard/3D_models/credit/Simple_Electric_longboard_remote_-_Arduino_controlled/files/plate-basic.stl

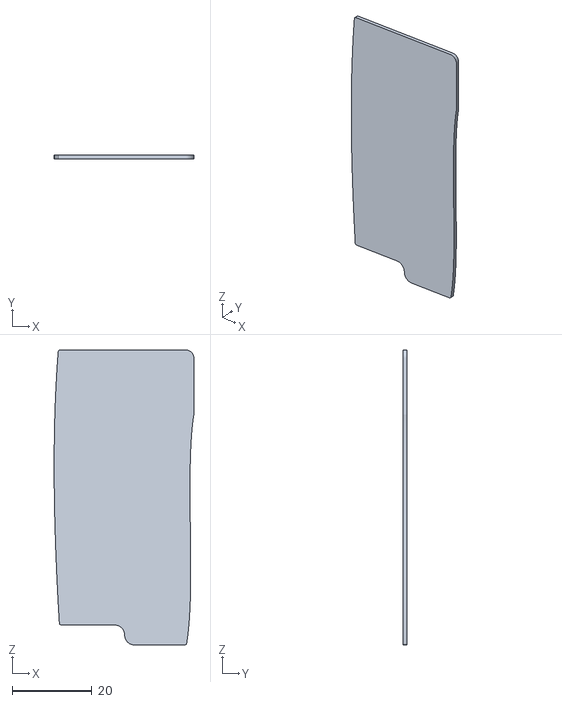
[picture p102: CAD file, 2021-04-29]
3D_models/credit/Simple_Electric_longboard_remote_-_Arduino_controlled/files/plate-basic.stl
35.1 x 1.00 x 74.0
