OfficialPouya/Safety_Suite_For_Electric_Longboard/(list of files, cad)

Other CAD files:
3D_models/credit/Simple_Electric_longboard_remote_-_Arduino_controlled/files/shell-bottom.stl
3D_models/credit/Simple_Electric_longboard_remote_-_Arduino_controlled/files/plate.stl
3D_models/3_2_21/OldVersions/hall_toll.0001.ipt
3D_models/3_2_21/OldVersions/trucks.0001.ipt
3D_models/3_2_21/hall_toll.ipt
3D_models/3_2_21/trucks.ipt
3D_models/Old/alignment_ring.ipt
3D_models/Old/tolerance_testing/OldVersions/magnet_hall_testing.0001.ipt
3D_models/Old/tolerance_testing/OldVersions/magnet_hall_testing_w_trucks.0001.ipt
3D_models/Old/tolerance_testing/magnet_hall_testing.ipt
3D_models/Old/tolerance_testing/magnet_hall_testing_w_trucks.ipt
3D_models/Old/trucks_2.ipt
3D_models/Old/wheel_magnet_mount/03_01_21_modified_wheelmount.stl
3D_models/Old/wheel_magnet_mount/36T_5m_kegel_pulley_9mm_belt_3d_print.stl
3D_models/Old/wheel_magnet_mount/OldVersions/modified_wheelmount.0001.ipt
3D_models/OldVersions/PCB_BOARD_Holder_.0001.ipt
3D_models/OldVersions/PCB_BOARD_NO_DREMEL_HOLES.0001.ipt
3D_models/OldVersions/PCB_REMOTE_Holder_.0001.ipt
3D_models/OldVersions/PCB_REMOTE_Holder_tall_.0002.ipt
3D_models/OldVersions/USB_MOUNT.0001.ipt
3D_models/OldVersions/alignment_ring.0002.ipt
3D_models/OldVersions/caliber_hall_mount.0001.ipt
3D_models/OldVersions/just_ring.0001.ipt
3D_models/OldVersions/trucks_2.0002.ipt
3D_models/PCB_BOARD_DREMEL_HOLES.ipt
3D_models/PCB_BOARD_Holder_.ipt
3D_models/PCB_BOARD_NO_DREMEL_HOLES.ipt
3D_models/PCB_REMOTE_Holder_.ipt
3D_models/PCB_REMOTE_Holder_cutout_.ipt
3D_models/PCB_REMOTE_Holder_tall_.ipt
3D_models/USB_MOUNT.ipt
3D_models/caliber_hall_mount.ipt
3D_models/credit/Electric_skateboard_motor_mount_-_Caliber_trucks/files/Imported Components/caliber/caliber.ipt
3D_models/credit/Electric_skateboard_motor_mount_-_Caliber_trucks/files/caliber_2.ipt
3D_models/credit/Remote/OldVersions/knob_bottom.0001.ipt
3D_models/credit/Remote/OldVersions/shell.0008.ipt
3D_models/credit/Remote/knob.ipt
3D_models/credit/Remote/knob_bottom.ipt
3D_models/credit/Remote/plate.ipt
3D_models/credit/Remote/retreat.ipt
3D_models/credit/Remote/shell-top.ipt
3D_models/credit/Remote/shell.ipt
3D_models/credit/Remote/switch.ipt
3D_models/just_ring.ipt
3D_models/remote/Just_Hall_Holder.ipt
3D_models/remote/Knob_With_Bearing_Middle_Hole.ipt
3D_models/remote/Old/cutout_shell_no_attach.ipt
3D_models/remote/Old/knob.ipt
3D_models/remote/Old/outline.dxf
3D_models/remote/Old/outline_better.dxf
3D_models/remote/Old/shell.dwg
3D_models/remote/Old/shell.ipt
3D_models/remote/Old/shell_mesh.ipt
3D_models/remote/OldVersions/Just_Hall_Holder.0002.ipt
3D_models/remote/OldVersions/Knob_With_Bearing_Middle_Hole.0001.ipt
3D_models/remote/OldVersions/cutout_shell_no_attach.0003.ipt
3D_models/remote/OldVersions/just_hall holder.0001.ipt
3D_models/remote/OldVersions/knob_bearing.0002.ipt
3D_models/remote/OldVersions/shell.0010.ipt
3D_models/remote/OldVersions/shell_no_attach.0006.ipt
3D_models/remote/OldVersions/switch.0005.ipt
3D_models/remote/OldVersions/switch_thick.0001.ipt
3D_models/remote/Shell_Bottom.ipt
3D_models/remote/retreat.ipt
3D_models/remote/shell-top.ipt
3D_models/remote/stl/Imported Components/shell_mesh/shell_mesh.ipt
3D_models/remote/stl/shell_3_24_11.ipt
3D_models/remote/switch.ipt
3D_models/remote/switch_thick.ipt
3D_models/retreat.ipt
eagle/remote/USB_C_Mount_Only.ipt
