OfficialPouya/Safety_Suite_For_Electric_Longboard/eagle/PCB Orders/4_6_21_Remote_SMD/pcbremote.brd

## EAGLE design eagle/PCB Orders/4_6_21_Remote_SMD/pcbremote.brd (2021-04-29)

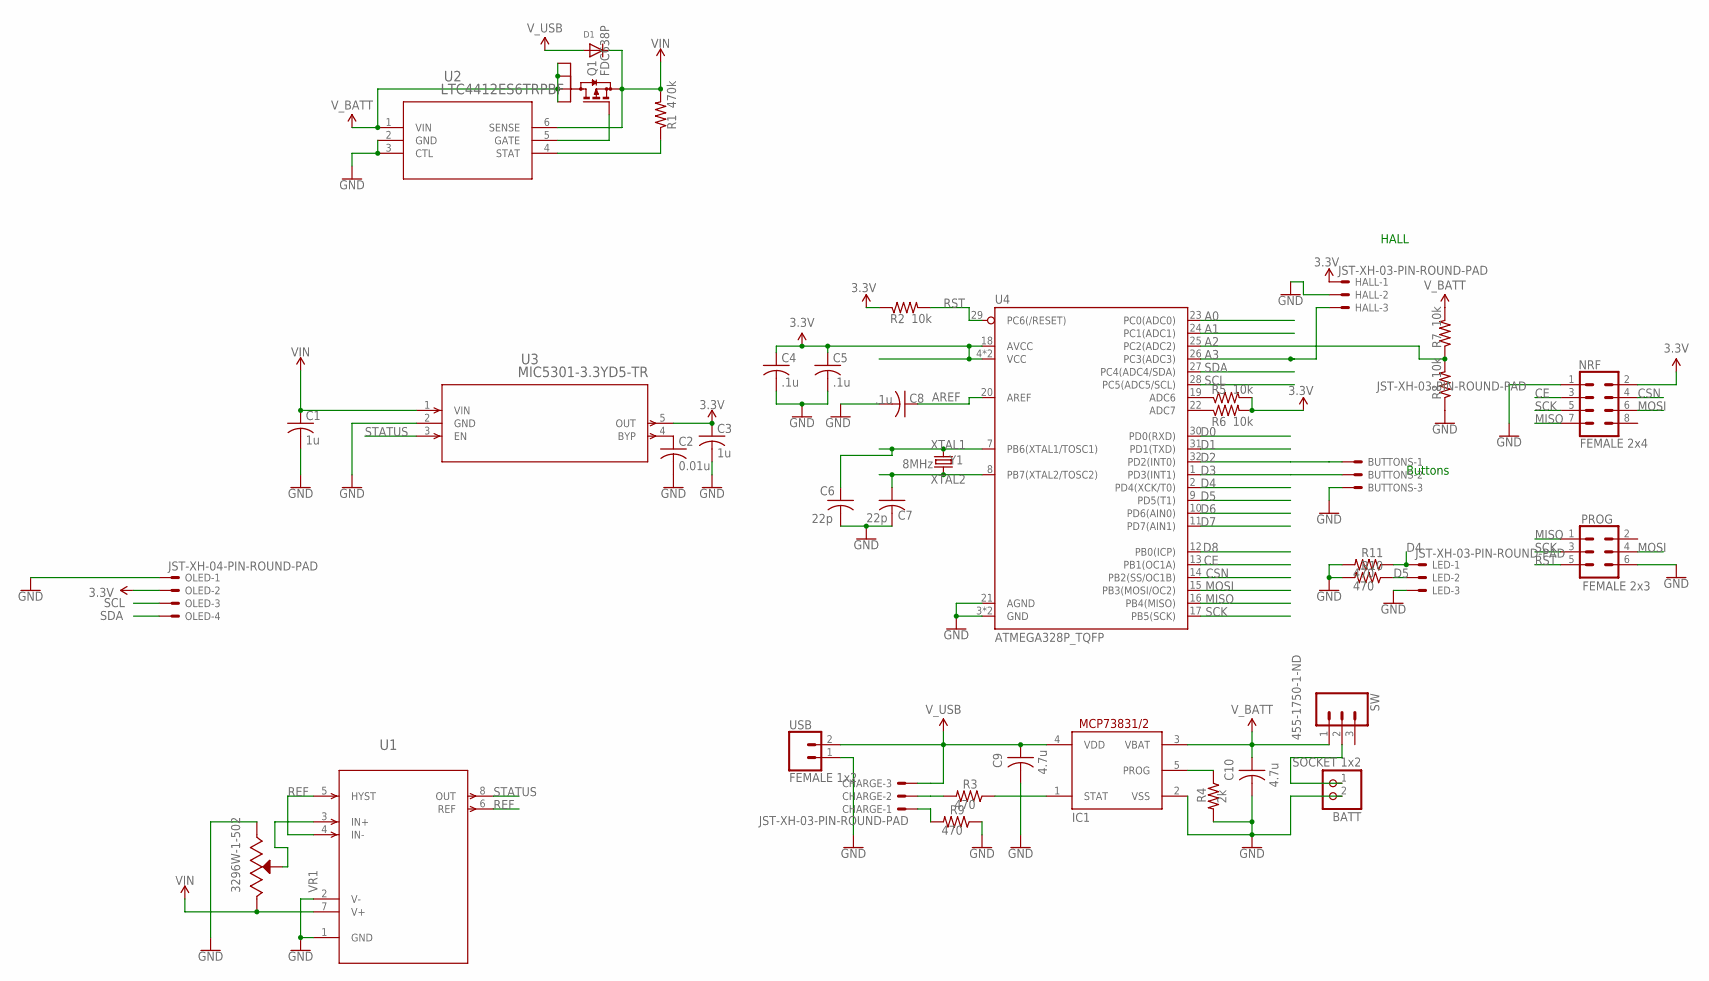
[picture p106: schematic pcbremote.sch]

Parts:
BATT: SOCKET 1x2; JST-PH-2-THM
BUTTONS: JST-XH-03-PIN-ROUND-PAD; JST-XH-03-PACKAGE-ROUND-PAD
C1, C3: 1u; C0805
C2: 0.01u; C0805
C4, C5, C8: .1u; C0805
C6, C7: 22p; C0805
C9, C10: 4.7u; C0805
CHARGE: JST-XH-03-PIN-ROUND-PAD; JST-XH-03-PACKAGE-ROUND-PAD
D1: DIODESOD-123; SOD-123
HALL: JST-XH-03-PIN-ROUND-PAD; JST-XH-03-PACKAGE-ROUND-PAD
IC1: MCP73831/OT; SOT23-5L
LED: JST-XH-03-PIN-ROUND-PAD; JST-XH-03-PACKAGE-ROUND-PAD
NRF: FEMALE 2x4; 2X4
OLED: JST-XH-04-PIN-ROUND-PAD; JST-XH-04-PACKAGE-ROUND-PAD
PROG: FEMALE 2x3; 2X3
Q1: FDC638P; SSOT-6
R1: 470k; R0805
R2, R5, R6, R7, R8: 10k; R0805
R3, R9, R10, R11: 470; R0805
R4: 2k; R0805
SW: 455-1750-1-ND; 1X03
U1: LTC1540CS8PBF; SO-8_S_LIT
U2: LTC4412ES6TRPBF; TSOT-23_S6_LIT
U3: MIC5301-3.3YD5-TR; TSOT-23-5_D5_MCH
U4: ATMEGA328P_TQFP; TQFP32-08
USB: FEMALE 1x2; 1X02
VR1: 3296W-1-502; TRIM_3296W-1-502
Y1: 8MHz; CRYSTAL-SMD-5X3.2-4PAD

Connections:
3.3V: C3.1, C4.1, C5.1, HALL.1, NRF.2, OLED.2, R2.1, R5.2, R6.2, U3.5 (OUT), U4.4 (VCC), U4.6 (VCC), U4.18 (AVCC)
A0: U4.23 (PC0(ADC0))
A1: U4.24 (PC1(ADC1))
A2: R7.1, R8.2, U4.25 (PC2(ADC2))
A3: HALL.3, U4.26 (PC3(ADC3))
AREF: C8.1, U4.20 (AREF)
CE: NRF.3, U4.13 (PB1(OC1A))
CSN: NRF.4, U4.14 (PB2(SS/OC1B))
D0: U4.30 (PD0(RXD))
D1: U4.31 (PD1(TXD))
D2: BUTTONS.1, U4.32 (PD2(INT0))
D3: BUTTONS.2, U4.1 (PD3(INT1))
D4: LED.1, R11.1, U4.2 (PD4(XCK/T0))
D5: LED.2, R10.1, U4.9 (PD5(T1))
D6: U4.10 (PD6(AIN0))
D7: U4.11 (PD7(AIN1))
D8: U4.12 (PB0(ICP))
GND: BATT.2 (1), BUTTONS.3, C1.2, C2.2, C3.2, C4.2, C5.2, C6.2, C7.2, C8.2, C9.2, C10.2, HALL.2, IC1.2 (VSS), LED.3, NRF.1, OLED.1, PROG.6, R4.2, R8.1, R9.1, R10.2, R11.2, U1.1 (GND), U1.2 (V-), U2.2 (GND), U2.3 (CTL), U3.2 (GND), U4.3 (GND), U4.5 (GND), U4.21 (AGND), USB.1, VR1.3 (CW)
MISO: NRF.7, PROG.1, U4.16 (PB4(MISO))
MOSI: NRF.6, PROG.4, U4.15 (PB3(MOSI/OC2))
unnamed: U1.3 (IN+), VR1.2 (WIPER)
unnamed: CHARGE.1, R9.2
unnamed: IC1.5 (PROG), R4.1
unnamed: IC1.1 (STAT), R3.1
unnamed: CHARGE.2, R3.2
unnamed: R5.1, U4.19 (ADC6)
unnamed: R6.1, U4.22 (ADC7)
unnamed: C2.1, U3.4 (BYP)
unnamed: Q1.3 (G), U2.5 (GATE)
unnamed: BATT.1 (2), SW.2
unnamed: R1.1, U2.4 (STAT)
REF: U1.4 (IN-), U1.5 (HYST), U1.6 (REF)
RST: PROG.5, R2.2, U4.29 (PC6(/RESET))
SCK: NRF.5, PROG.3, U4.17 (PB5(SCK))
SCL: OLED.3, U4.28 (PC5(ADC5/SCL))
SDA: OLED.4, U4.27 (PC4(ADC4/SDA))
STATUS: U1.8 (OUT), U3.3 (EN)
VIN: C1.1, D1.C, Q1.4 (S), R1.2, U1.7 (V+), U2.6 (SENSE), U3.1 (VIN), VR1.1 (CCW)
V_BATT: C10.1, IC1.3 (VBAT), Q1.1 (D4), Q1.2 (D1), Q1.5 (D2), Q1.6 (D3), R7.2, SW.1, U2.1 (VIN)
V_USB: C9.1, CHARGE.3, D1.A, IC1.4 (VDD), USB.2
XTAL1: C6.1, U4.7 (PB6(XTAL1/TOSC1)), Y1.1
XTAL2: C7.1, U4.8 (PB7(XTAL2/TOSC2)), Y1.3 (2)

Notes on the sheet:
Buttons
HALL

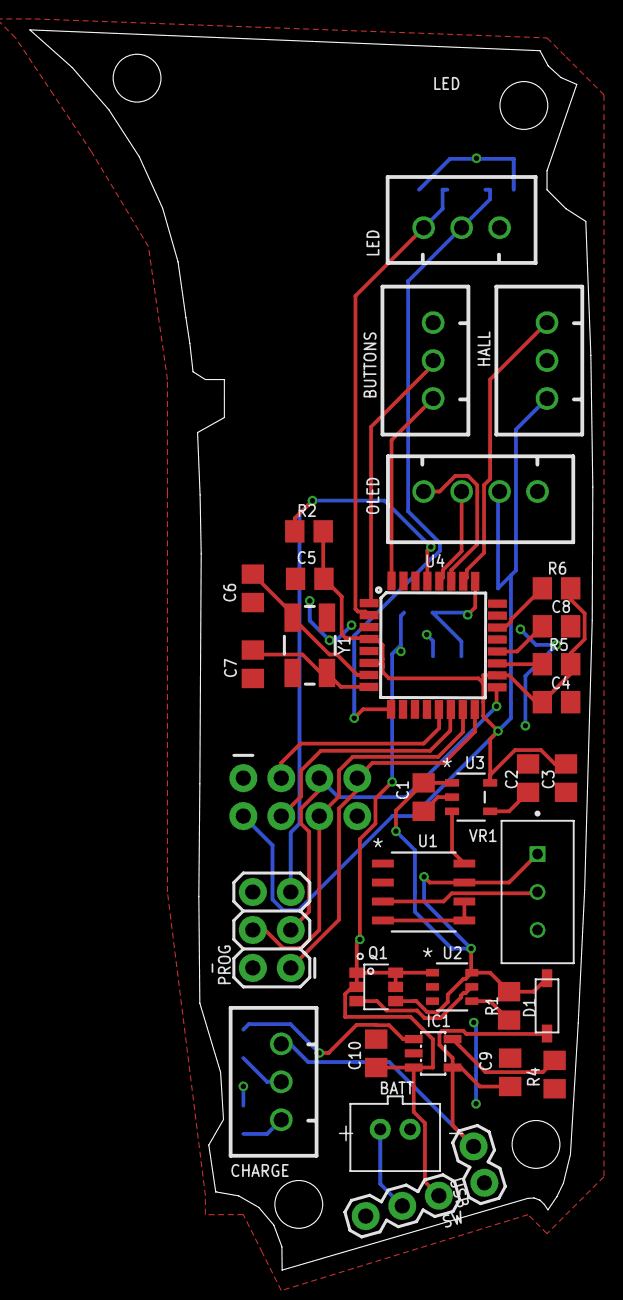
[picture p107: board eagle/PCB Orders/4_6_21_Remote_SMD/pcbremote.brd from above]

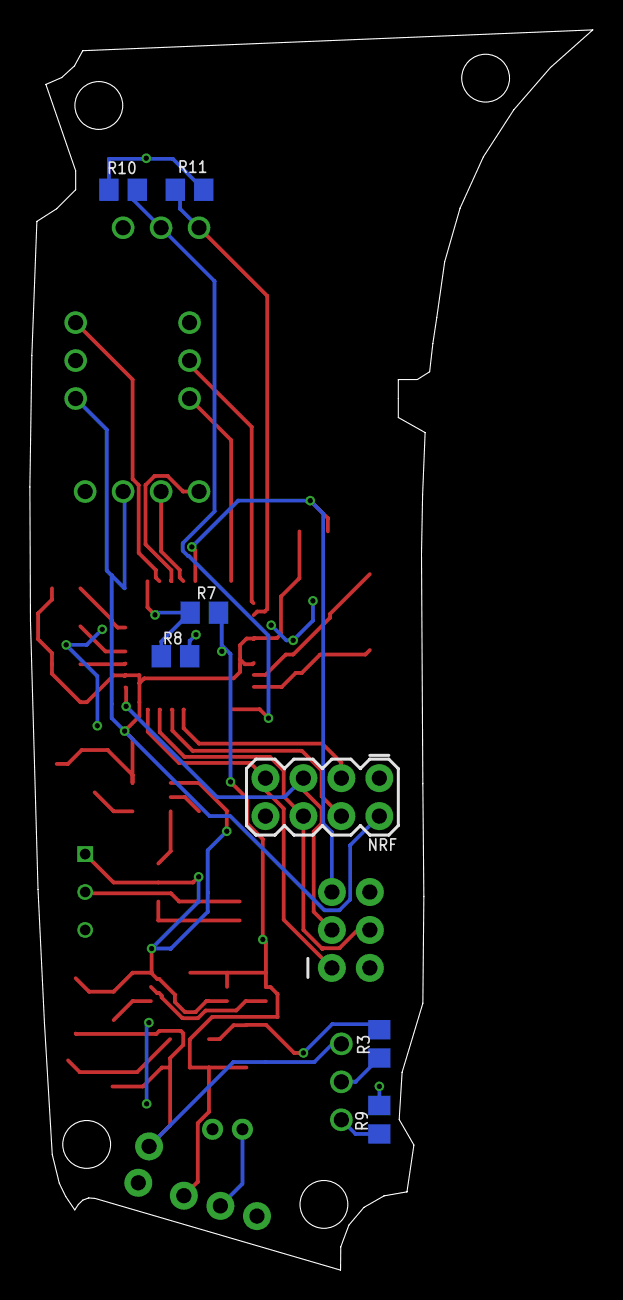
[picture p108: board eagle/PCB Orders/4_6_21_Remote_SMD/pcbremote.brd from below]

Board: 2 copper layers, 37.7 x 83.0 mm, 40 parts (7 on the bottom side), 35 nets.
