OfficialPouya/Safety_Suite_For_Electric_Longboard/eagle/PCB Orders/3_18_21_Remote_DIP/pcbremote.brd

## EAGLE design eagle/PCB Orders/3_18_21_Remote_DIP/pcbremote.brd (2021-04-29)

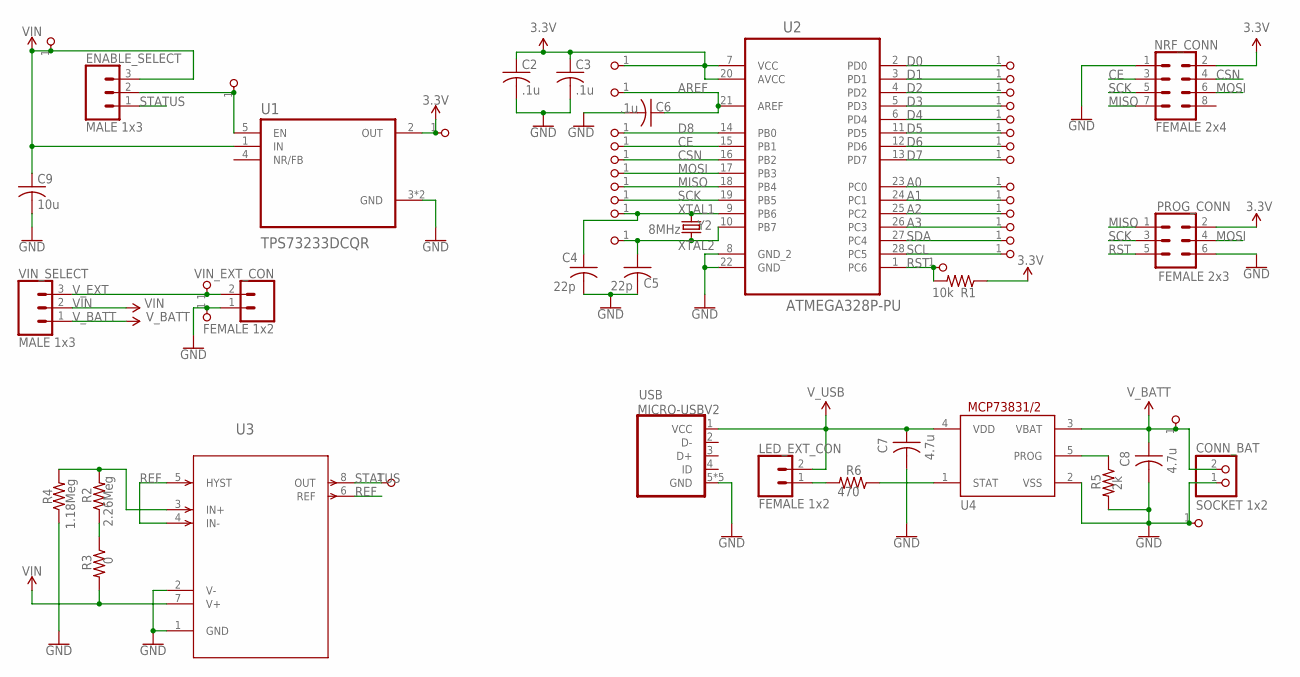
[picture p109: schematic pcbremote.sch]

Parts:
3.3V: PINHD-1X1; 1X01
A0, A1, A2, A3: PINHD-1X1; 1X01
AREF: PINHD-1X1; 1X01
C2, C3, C6: .1u; C0805
C4, C5: 22p; C0805
C7, C8: 4.7u; C0805
C9: 10u; C0805
CE: PINHD-1X1; 1X01
CONN_BAT: SOCKET 1x2; JST-PH-2-THM
CSN: PINHD-1X1; 1X01
D0, D1, D2, D3, D4, D5, D6, D7, D8: PINHD-1X1; 1X01
EN: PINHD-1X1; 1X01
ENABLE_SELECT: MALE 1x3; 1X03
GND, GND7: PINHD-1X1; 1X01
LED_EXT_CON: FEMALE 1x2; 1X02
MISO: PINHD-1X1; 1X01
MOSI: PINHD-1X1; 1X01
NRF_CONN: FEMALE 2x4; 2X4
PROG_CONN: FEMALE 2x3; 2X3
R1: 10k; R0805
R2: 2.26Meg; R0805
R3: 0; R0805
R4: 1.18Meg; R0805
R5: 2k; R0805
R6: 470; R0805
RESET: PINHD-1X1; 1X01
SCK: PINHD-1X1; 1X01
SCL: PINHD-1X1; 1X01
SDA: PINHD-1X1; 1X01
STATUS: PINHD-1X1; 1X01
U1: TPS73233DCQR; SOT127P706X180-6N
U2: ATMEGA328P-PU; DIP254P762X457-28
U3: LTC1540CS8PBF; SO-8_S_LIT
U4: MCP73831/OT; SOT23-5L
USB: MICRO-USBV2; MICRO-USB-2
VCC: PINHD-1X1; 1X01
VIN: PINHD-1X1; 1X01
VIN_EXT: PINHD-1X1; 1X01
VIN_EXT_CON: FEMALE 1x2; 1X02
VIN_SELECT: MALE 1x3; 1X03
V_BATT: PINHD-1X1; 1X01
XTAL1, XTAL2: PINHD-1X1; 1X01
Y2: 8MHz; CRYSTAL-SMD-5X3.2-4PAD

Connections:
3.3V: 3.3V.1, C2.1, C3.1, NRF_CONN.2, PROG_CONN.2, R1.1, U1.2 (OUT), U2.7 (VCC), U2.20 (AVCC), VCC.1
A0: A0.1, U2.23 (PC0)
A1: A1.1, U2.24 (PC1)
A2: A2.1, U2.25 (PC2)
A3: A3.1, U2.26 (PC3)
AREF: AREF.1, C6.1, U2.21 (AREF)
CE: CE.1, NRF_CONN.3, U2.15 (PB1)
CSN: CSN.1, NRF_CONN.4, U2.16 (PB2)
D0: D0.1, U2.2 (PD0)
D1: D1.1, U2.3 (PD1)
D2: D2.1, U2.4 (PD2)
D3: D3.1, U2.5 (PD3)
D4: D4.1, U2.6 (PD4)
D5: D5.1, U2.11 (PD5)
D6: D6.1, U2.12 (PD6)
D7: D7.1, U2.13 (PD7)
D8: D8.1, U2.14 (PB0)
GND: C2.2, C3.2, C4.2, C5.2, C6.2, C7.2, C8.2, C9.2, CONN_BAT.1 (2), GND.1, GND7.1, NRF_CONN.1, PROG_CONN.6, R4.1, R5.2, U1.3 (GND), U1.6 (GND), U2.8 (GND_2), U2.22 (GND), U3.1 (GND), U3.2 (V-), U4.2 (VSS), USB.5 (GND), USB.P$1 (GND), USB.P$2 (GND), USB.P$3 (GND), USB.P$4 (GND), VIN_EXT_CON.1
MISO: MISO.1, NRF_CONN.7, PROG_CONN.1, U2.18 (PB4)
MOSI: MOSI.1, NRF_CONN.6, PROG_CONN.4, U2.17 (PB3)
unnamed: R2.2, R4.2, U3.3 (IN+)
unnamed: R2.1, R3.1
unnamed: R5.1, U4.5 (PROG)
unnamed: R6.1, U4.1 (STAT)
unnamed: LED_EXT_CON.1, R6.2
unnamed: EN.1, ENABLE_SELECT.2, U1.5 (EN)
REF: U3.4 (IN-), U3.5 (HYST), U3.6 (REF)
RST: PROG_CONN.5, R1.2, RESET.1, U2.1 (PC6)
SCK: NRF_CONN.5, PROG_CONN.3, SCK.1, U2.19 (PB5)
SCL: SCL.1, U2.28 (PC5)
SDA: SDA.1, U2.27 (PC4)
STATUS: ENABLE_SELECT.1, STATUS.1, U3.8 (OUT)
VIN: C9.1, ENABLE_SELECT.3, R3.2, U1.1 (IN), U3.7 (V+), VIN.1, VIN_SELECT.2
V_BATT: C8.1, CONN_BAT.2 (1), U4.3 (VBAT), VIN_SELECT.1, V_BATT.1
V_EXT: VIN_EXT.1, VIN_EXT_CON.2, VIN_SELECT.3
V_USB: C7.1, LED_EXT_CON.2, U4.4 (VDD), USB.1 (VCC)
XTAL1: C4.1, U2.9 (PB6), XTAL1.1, Y2.1
XTAL2: C5.1, U2.10 (PB7), XTAL2.1, Y2.3 (2)

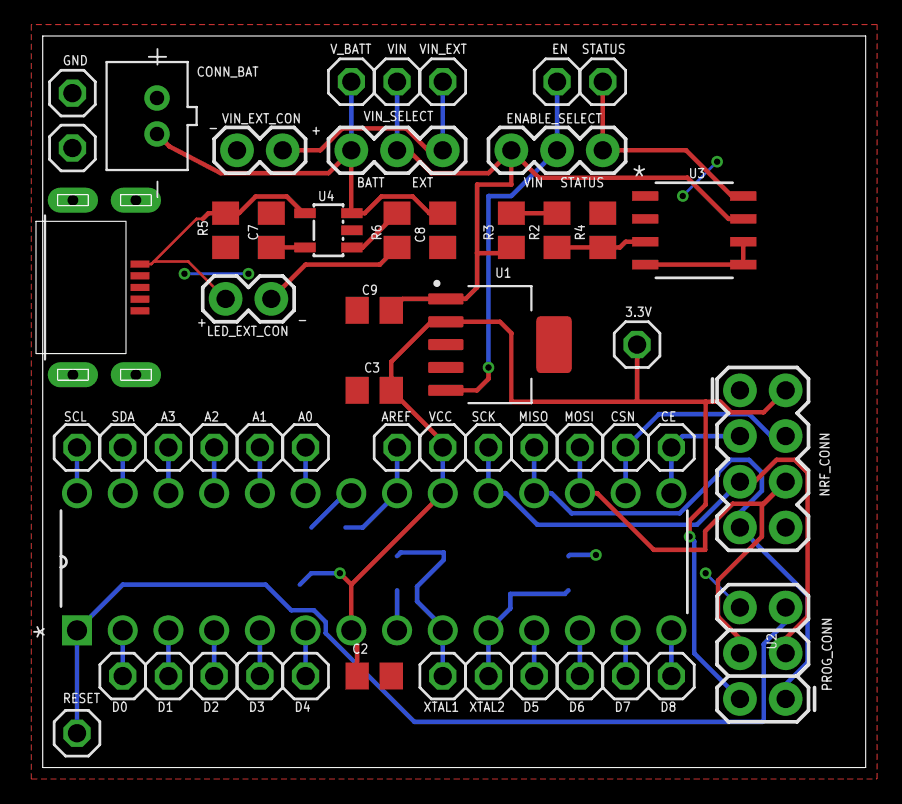
[picture p110: board eagle/PCB Orders/3_18_21_Remote_DIP/pcbremote.brd from above]

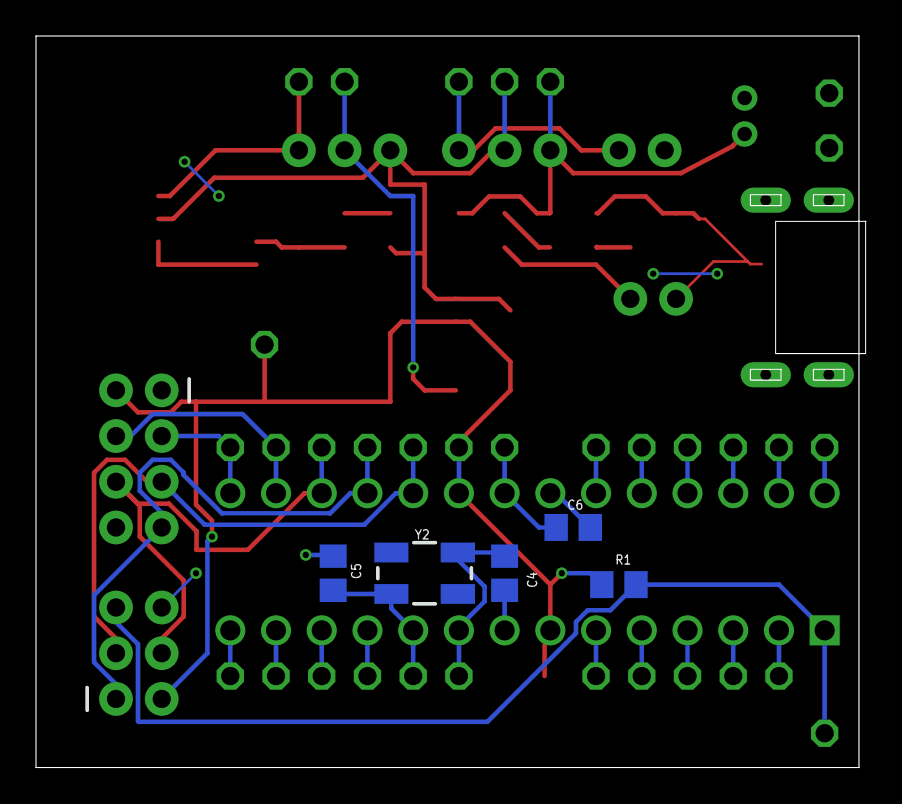
[picture p111: board eagle/PCB Orders/3_18_21_Remote_DIP/pcbremote.brd from below]

Board: 2 copper layers, 45.7 x 40.6 mm, 60 parts (5 on the bottom side), 38 nets.
