OfficialPouya/Safety_Suite_For_Electric_Longboard/eagle/PCB Orders/4_6_21_Board_DIP/pcbboard.brd

## EAGLE design eagle/PCB Orders/4_6_21_Board_DIP/pcbboard.brd (2021-04-29)

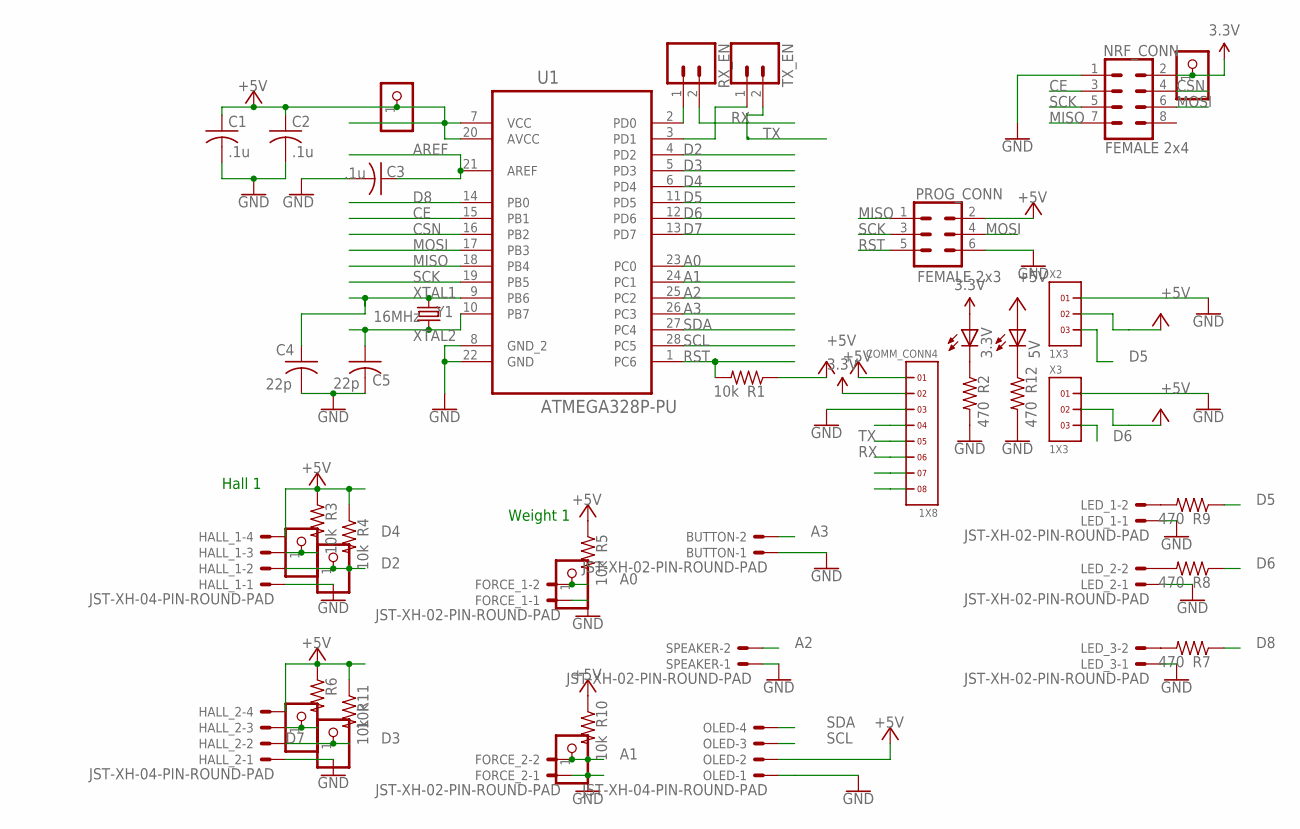
[picture p112: schematic pcbboard.sch]

Parts:
3.3V, 5V: LED3MM
BUTTON: JST-XH-02-PIN-ROUND-PAD; JST-XH-02-PACKAGE-ROUND-PAD
C1, C2, C3: .1u; C0805
C4, C5: 22p; C0805
COMM_CONN4: 1X8
FORCE_1, FORCE_2: JST-XH-02-PIN-ROUND-PAD; JST-XH-02-PACKAGE-ROUND-PAD
HALL_1, HALL_2: JST-XH-04-PIN-ROUND-PAD; JST-XH-04-PACKAGE-ROUND-PAD
LED_1, LED_2, LED_3: JST-XH-02-PIN-ROUND-PAD; JST-XH-02-PACKAGE-ROUND-PAD
NRF_CONN: FEMALE 2x4; 2X4
OLED: JST-XH-04-PIN-ROUND-PAD; JST-XH-04-PACKAGE-ROUND-PAD
PROG_CONN: FEMALE 2x3; 2X3
R1, R3, R4, R5, R6, R10, R11: 10k; R0805
R2, R7, R8, R9, R12: 470; R0805
RX_EN: CONN_02; 1X02
SPEAKER: JST-XH-02-PIN-ROUND-PAD; JST-XH-02-PACKAGE-ROUND-PAD
TP_3.3V, TP_5V: PINHD-1X1; 1X01
TP_F1, TP_F2: PINHD-1X1; 1X01
TP_H1-1, TP_H1-2, TP_H2-1, TP_H2-2: PINHD-1X1; 1X01
TX_EN: CONN_02; 1X02
U1: ATMEGA328P-PU; DIP254P762X457-28
X2, X3: 1X3
Y1: 16MHz; CRYSTAL-SMD-5X3.2-4PAD

Connections:
3.3V: 3.3V.A, COMM_CONN4.2, NRF_CONN.2, TP_3.3V.1
+5V: 5V.A, C1.1, C2.1, COMM_CONN4.1, HALL_1.4, HALL_2.4, OLED.2, PROG_CONN.2, R1.1, R3.1, R4.1, R5.1, R6.1, R10.1, R11.1, TP_5V.1, U1.7 (VCC), U1.20 (AVCC), X2.2, X3.2
A0: FORCE_1.2, R5.2, TP_F1.1, U1.23 (PC0)
A1: FORCE_2.2, R10.2, TP_F2.1, U1.24 (PC1)
A2: SPEAKER.2, U1.25 (PC2)
A3: BUTTON.2, U1.26 (PC3)
AREF: C3.1, U1.21 (AREF)
CE: NRF_CONN.3, U1.15 (PB1)
CSN: NRF_CONN.4, U1.16 (PB2)
D2: HALL_1.2, R4.2, TP_H1-2.1, U1.4 (PD2)
D3: HALL_2.2, R11.2, TP_H2-2.1, U1.5 (PD3)
D4: HALL_1.3, R3.2, TP_H1-1.1, U1.6 (PD4)
D5: R9.1, U1.11 (PD5), X2.3
D6: R8.1, U1.12 (PD6), X3.3
D7: HALL_2.3, R6.2, TP_H2-1.1, U1.13 (PD7)
D8: R7.1, U1.14 (PB0)
GND: BUTTON.1, C1.2, C2.2, C3.2, C4.2, C5.2, COMM_CONN4.3, FORCE_1.1, FORCE_2.1, HALL_1.1, HALL_2.1, LED_1.1, LED_2.1, LED_3.1, NRF_CONN.1, OLED.1, PROG_CONN.6, R2.2, R12.2, SPEAKER.1, U1.8 (GND_2), U1.22 (GND), X2.1, X3.1
MISO: NRF_CONN.7, PROG_CONN.1, U1.18 (PB4)
MOSI: NRF_CONN.6, PROG_CONN.4, U1.17 (PB3)
unnamed: LED_3.2, R7.2
unnamed: LED_2.2, R8.2
unnamed: LED_1.2, R9.2
unnamed: 3.3V.K (C), R2.1
unnamed: 5V.K (C), R12.1
unnamed: RX_EN.1, U1.2 (PD0)
unnamed: TX_EN.1, U1.3 (PD1)
RST: PROG_CONN.5, R1.2, U1.1 (PC6)
RX: COMM_CONN4.6, RX_EN.2
SCK: NRF_CONN.5, PROG_CONN.3, U1.19 (PB5)
SCL: OLED.3, U1.28 (PC5)
SDA: OLED.4, U1.27 (PC4)
TX: COMM_CONN4.5, TX_EN.2
XTAL1: C4.1, U1.9 (PB6), Y1.1
XTAL2: C5.1, U1.10 (PB7), Y1.3 (2)

Notes on the sheet:
Hall 1
Weight 1

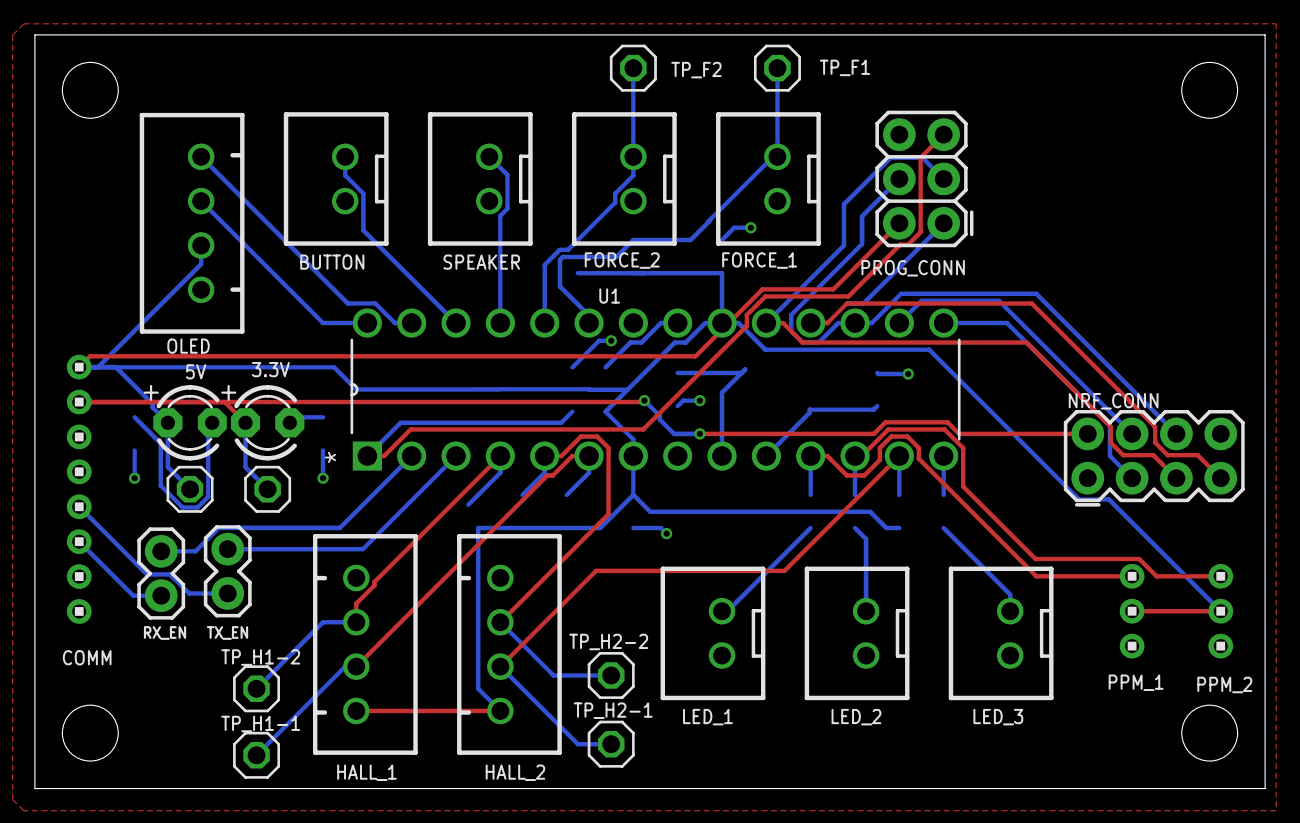
[picture p113: board pcbboard.brd from above]

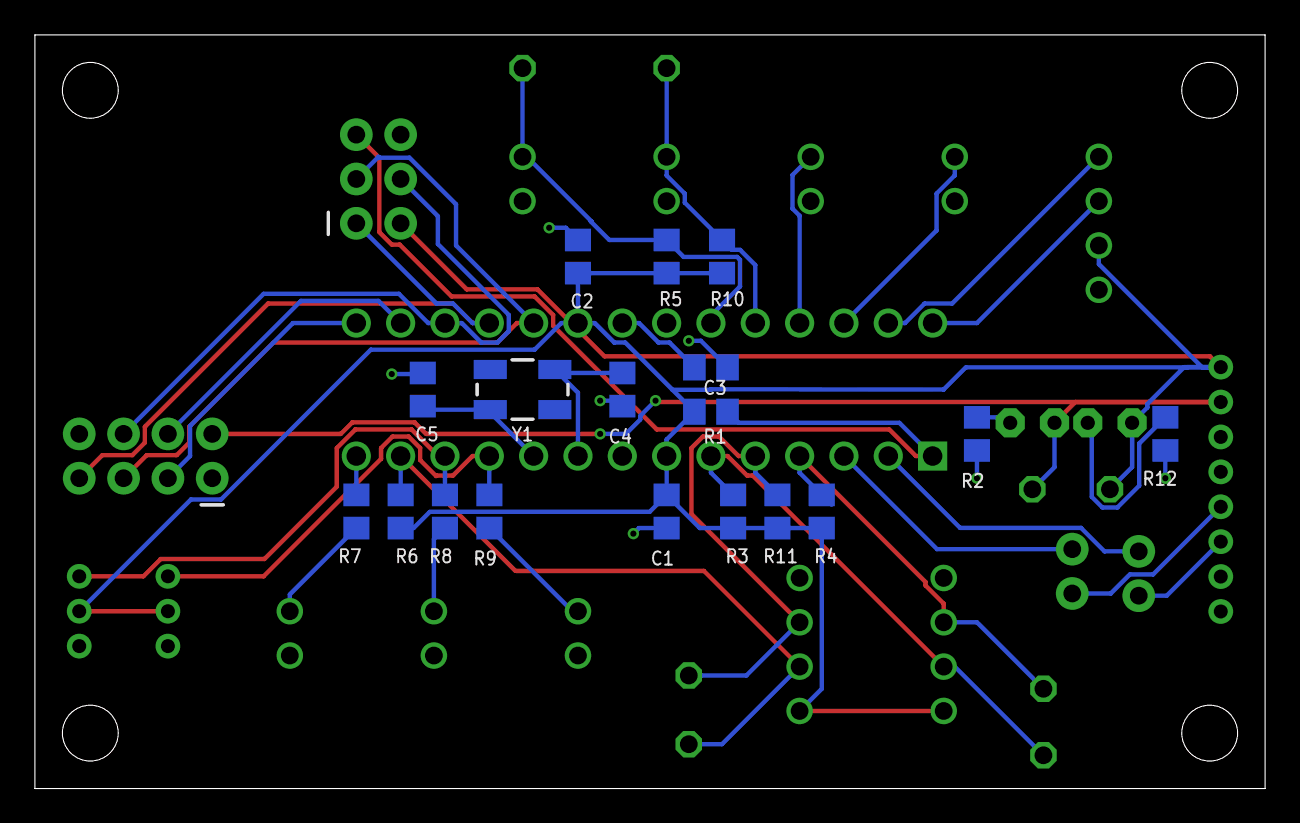
[picture p114: board pcbboard.brd from below]

Board: 2 copper layers, 70.5 x 43.2 mm, 46 parts (18 on the bottom side), 34 nets.
