OfficialPouya/Safety_Suite_For_Electric_Longboard/(commit log)

2021-03-02 LED corresponding payload
2021-03-07 code for board comms with remote done
2021-03-07 added remote comm to board
2021-03-07 added code receipt from board to controller
2021-03-15 updated timing for board
2021-03-30 pin mismatch
2021-03-30 value fixes. 2way with ack fully works
    [2way_remote.ino]
2021-04-04 added hall effect
2021-04-09 rpm reading fixed, code cleaned up, needs more comments
    [rpm_reading.ino]
2021-04-19 board and remote v3 working
2021-04-19 added buzzer for slip and eject and loss of connection detection
    [remote_test_V3.ino]
2021-04-19 made buzzers not buzz as long
    [remote_test_V3.ino]
2021-04-19 board speaker implemented
2021-04-19 hall effect range help
2021-04-19 remote test now can be monitored
    corrected pins for remote to match final product. Decreased transmission delay. added code to monitor rpm from wirelessly.
    [board_test_V3.ino, remote_test_V4.ino]
2021-04-20 updated with new throttle val
2021-04-29 added 3d models, pcbs from pats branch to main
    [03_01_21_modified_wheelmount.stl, 36T_5m_kegel_pulley_9mm_belt_3d_print.stl, Bottom.stl, Just_Hall_Holder.0002.ipt, Just_Hall_Holder.ipt, Knob_With_Bearing_Middle_Hole.0001.ipt, Knob_With_Bearing_Middle_Hole.ipt, PCB_BOARD_DREMEL_HOLES.ipt]
