OfficialPouya/Safety_Suite_For_Electric_Longboard/(notices)

Notices in the files:
DEV Work/comms_dev/Obselete/Nunchuk_Reading_Values_Test/Nunchuk_Reading_Values_Test.ino:
This program is free software: you can redistribute it and/or modify
it under the terms of the GNU Lesser General Public License as published by
the Free Software Foundation, either version 3 of the License, or
(at your option) any later version.
parts and their libraries:
SparkFun-Connectors: Licensing: Creative Commons ShareAlike 4.0 International - https://creativecommons.org/licenses/by-sa/4.0
MIC5301: COPYRIGHT: Copyright (C) 2018 Accelerated Designs. All rights reserved
